LightWare-Optoelectronics/lightware-dji-sdk/README.md

# lightware-dji-sdk

Documentation and source code for integrating LightWare sensors into the DJI eco-system.

Please view the online documentation here: https://lightware-optoelectronics.github.io/lightware-dji-sdk/
