LightWare-Optoelectronics/lightware-dji-sdk/docs/landing-moving-platform/hardware/index.html

Skip to main content

On this page

# Hardware

## Sensor settings and firmware

Each LightWare LW20/C is pre-configured an I2C address of 0x66. To differentiate the four devices on the bus, each device will have to be configured with a unique address.

Configuration of the LightWare devices is accomplished with LightWare Studio (https://lightwarelidar.com/resources-software/).

Connect each sensor to the Generic USB adaptor. Update the firmware and change the I2C address as described in the Product Guide (https://lightwarelidar.com/resources-active-manuals-datasheets/).

LightWare Studio denotes the I2C addresses in decimal. The table below shows four decimal values for the corresponding hexadecimal values.

Decimal | Hex
102 | 0x66
103 | 0x67
104 | 0x68
105 | 0x69

Mark each sensor with its address as their position on the aircraft will be relevant for future logic setups.

## Assembling the hardware

### Sensor mounting

Start by preparing the mounting rails and clips that will hold the sensors securely on the underside of the aircraft.

Attach the mounting clips to the rails, which will later be secured to the drone. Using countersunk screws, fasten the clips as demonstrated in the image below to ensure a snug and stable fit for the sensors.

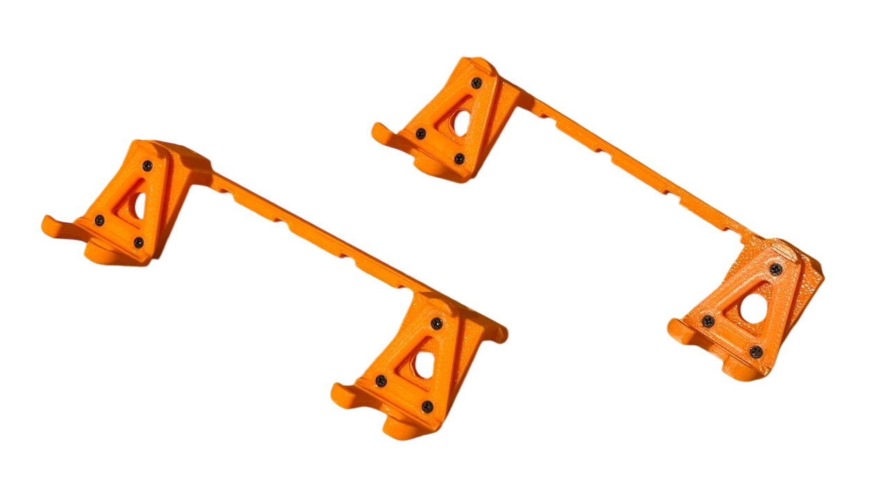
[picture p1: docs/assets/images/clipsonrails-0dd674a2cffb2f62185db07fd3b68879.png]
Mounted clips to the rails


### Communications cable preparation

Strip the pre-attached LightWare connector from the end of the communications cables from each of the LiDAR sensors and prepare the cable for connecting the Dupont connectors.

Connect the black (GND), red (VCC), white (RX/SCL), and yellow (TX/SDA) wires from the LW20/C and crimp each one individually using Dupont connectors. Ensure each wire is firmly secured within its connector to avoid any loose connections.

Once crimped, insert the wires into a single 4-pin Dupont housing in the following order:

- Black (GND)
- Red (VCC)
- White (RX/SCL)
- Yellow (TX/SDA)

This will ensure proper alignment for easy connection to the appropriate ports on the onboard computer or other components.

Double-check that the wires are inserted in the correct order and securely held within the connector housing.

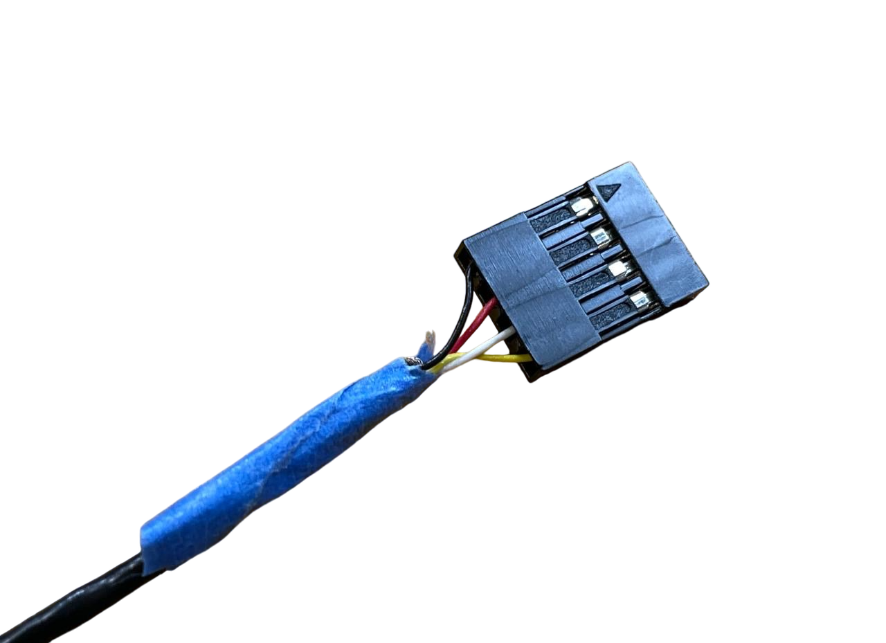
[picture p2: docs/assets/images/crimpedwiresonlw20-8d907b380153e8a405eb422df559ffc8.png]
Crimped Wires on LW20/c


### Mounting the sensors

Begin by attaching the 3D-printed bracket to the underside of the M350 drone. Carefully flip the aircraft upside down - it's best to do this step now since the computer will be installed later.

Remove the payload screws and set them aside in case it is needed to detach the kit in the future.

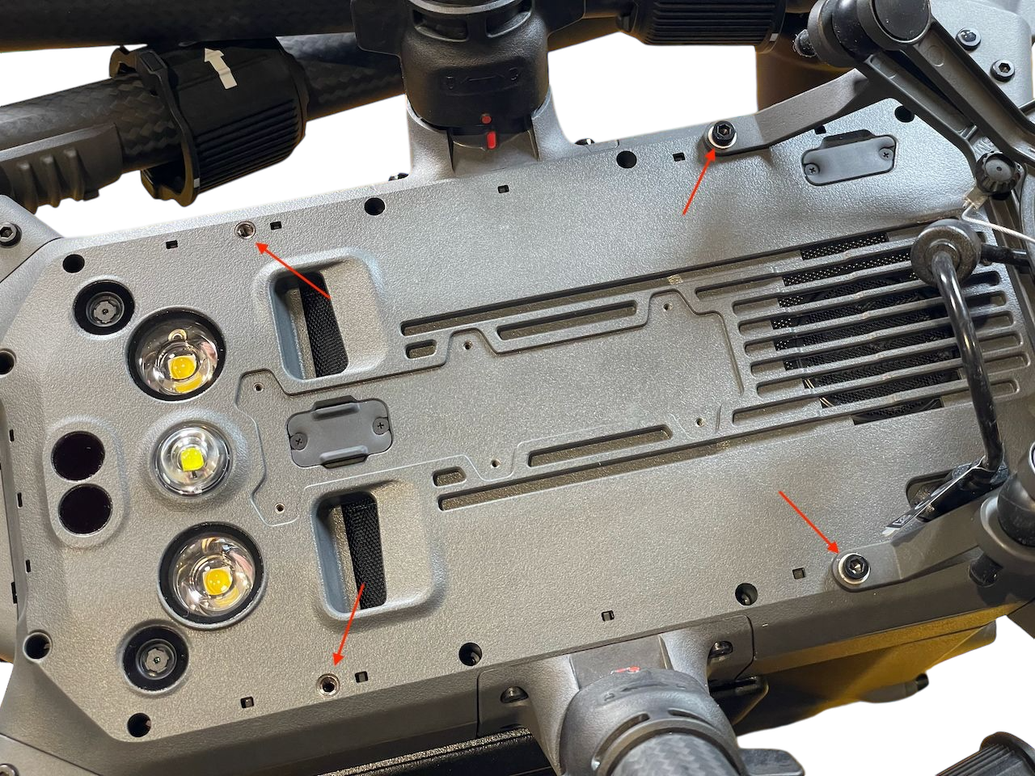
[picture p3: docs/assets/images/m350onitshead-d6d881d67124785eacda940005cbc7aa.png]
M350 on its head


Secure the rails to the drone using M3x10mm screws for the front (where the payload is located) and M3x8mm screws for the back.

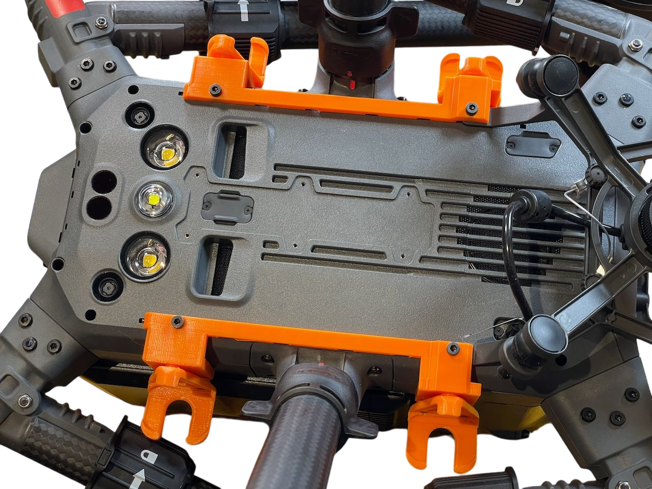
[picture p4: docs/assets/images/railsinstalled-2eea33e8801ef78d0a54aa22e9cdf384.png]
Rails installed


Next, clip the sensor onto the 3D-printed bracket. To manage the cables, use adhesive putty (like Blu Tack or similar) to keep them neatly secured against the body of the aircraft.

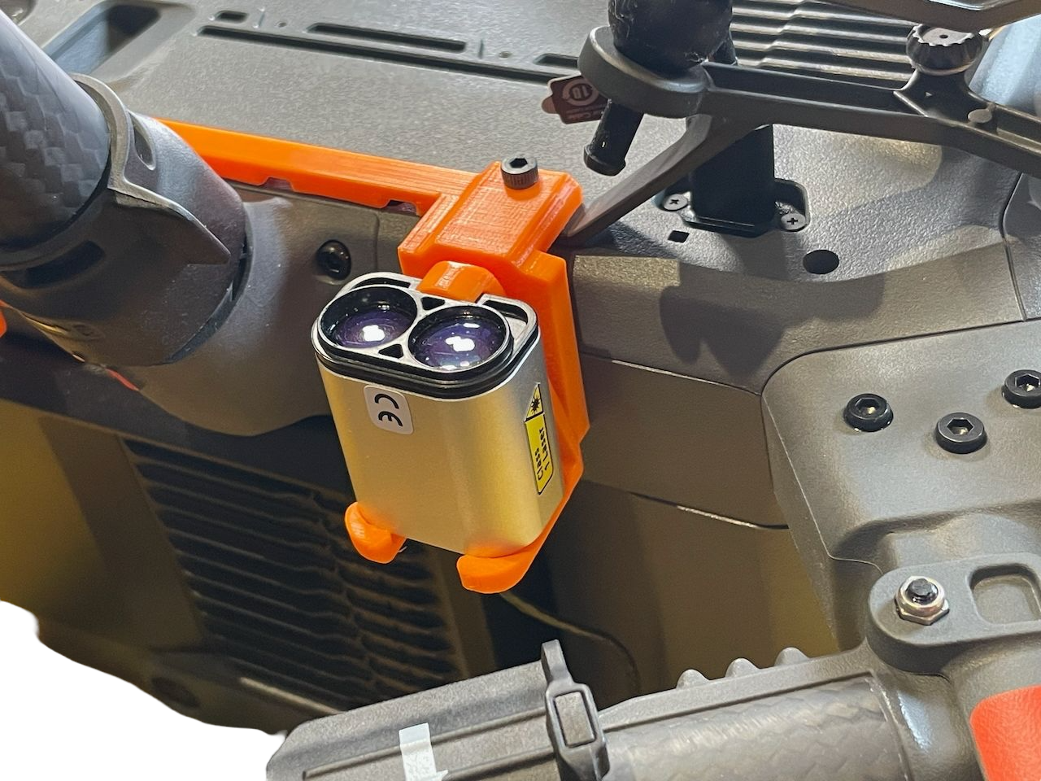
[picture p5: docs/assets/images/lw20installed-0057602dd733ce7a632730611499ee80.png]
LW20/c installed and wire attached with blutac
 LW20/c installed and wire attached with blutac

Alternative cable routing

For production deployments, there are more durable methods to secure the cables, including printing a cable guide brace between the two mounting brackets. This guide focuses on R&D and quick validation of the end-to-end system. An alternative option would be to route the cables through the rails and secure them with zip ties. The rails are designed to accommodate this. The wire length may need to be extended for the rear sensors. The cables can also be guided along the side of the aircraft using adhesive putty, taking care not to obstruct the view of the obstacle avoidance sensors.

### Preparing the compute unit mounting

Use M2.5 heat-set inserts for the Raspberry Pi posts on the compute mount. Use a soldering iron at the melting temperature appropriate for the plastic used in the printing of the mount. Carefully insert the heat-set and remove the iron once the insert is sufficiently embedded.

The heat-set inserts are optional but recommended for a more secure fit. An alternative would be to use self-tapping screws directly into the plastic mount.

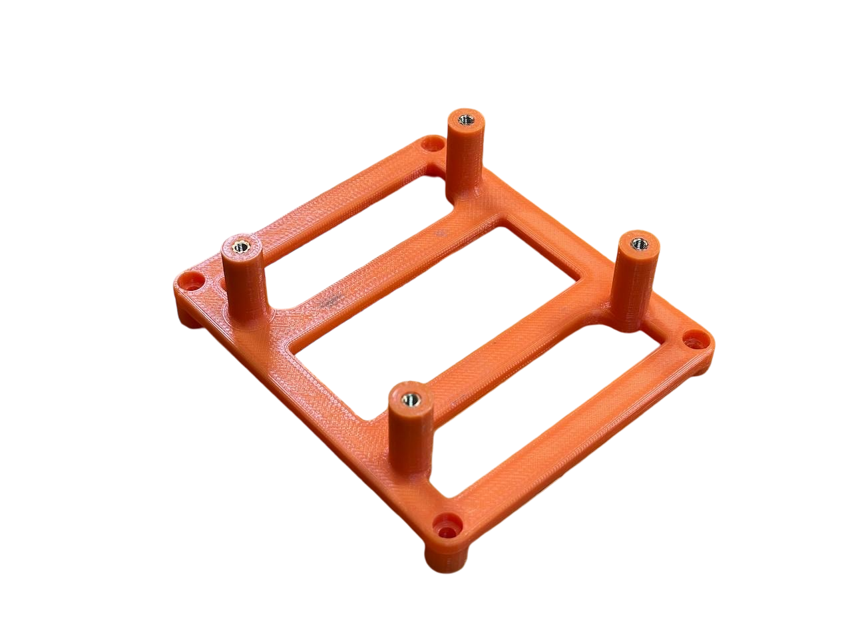
[picture p6: docs/assets/images/computemountwiththreaded-6a1992a9199ea5ea620ba9f0d8d41797.png]
Compute mount with threaded insert posts


### Preparing the voltage regulator mounting

The voltage regulator which will supply power to the Raspberry Pi and the I2C breakout board.

Install the heat-set inserts into the board, following the same process used previously. Use a soldering iron at the appropriate temperature to ensure the inserts are securely in place.

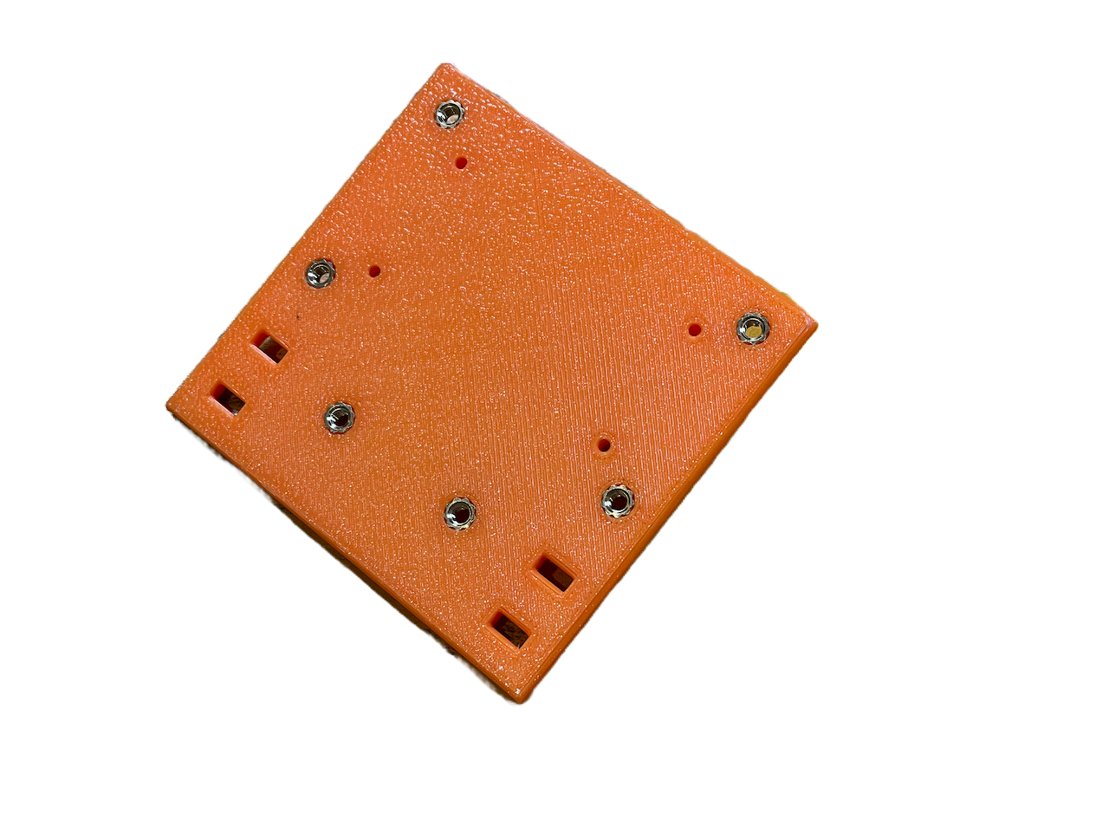
[picture p7: docs/assets/images/voltageboardwithinserts-5d5ddf76be71025a42b82e306a12f6ed.png]
Voltage board with inserts


When using an alternative I2C bus and voltage regulator configuration, ensure that the required power is supplied for the Raspberry Pi to function properly.

### Mounting the E-Port kit

The E-Port Kit will be positioned underneath the Raspberry Pi. Place the E-Port kit as seen on the picture below, aligning the E-Port kit inside the securing post.

Secure the board to the mount using a zip tie.

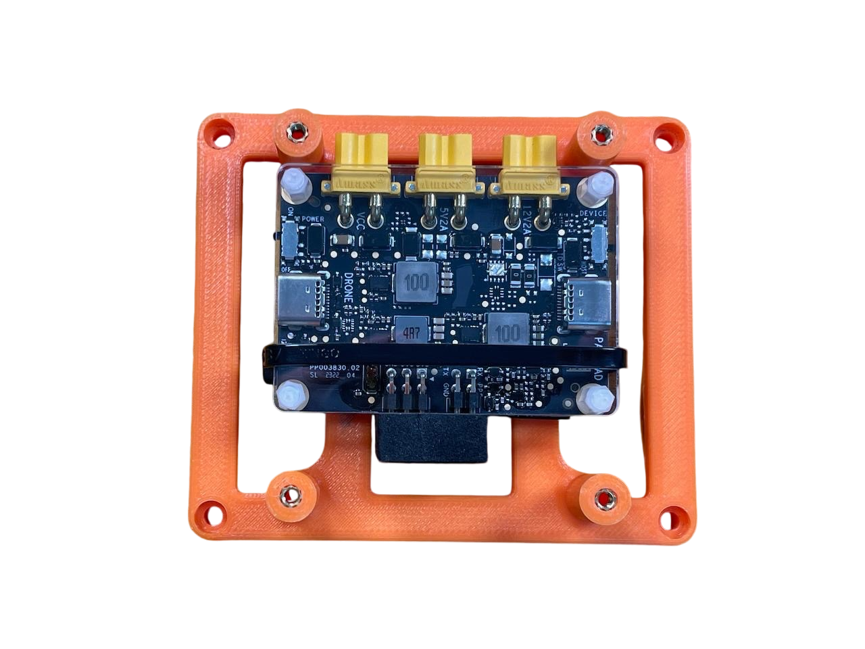
[picture p8: docs/assets/images/eportonmount-82ff57d64357cf5bc505caa2b5e3919b.png]
E-port on mount


Ensure that the "Drone" USB-C port on the E-Port Kit is facing the starboard (right) side of the mount. This orientation is crucial for proper functionality.

Verify that the E-Port Kit is firmly in place before proceeding to the next step.

### Connect the USB/TTL cable

While having a clear view of the markings on the PCB, and before moving on to the Raspberry Pi, connect the USB/TTL cable to the pins on the E-Port Kit.

Connect the USB-C cable from the kit, ensuring that the "B" side of the cable is facing upwards.

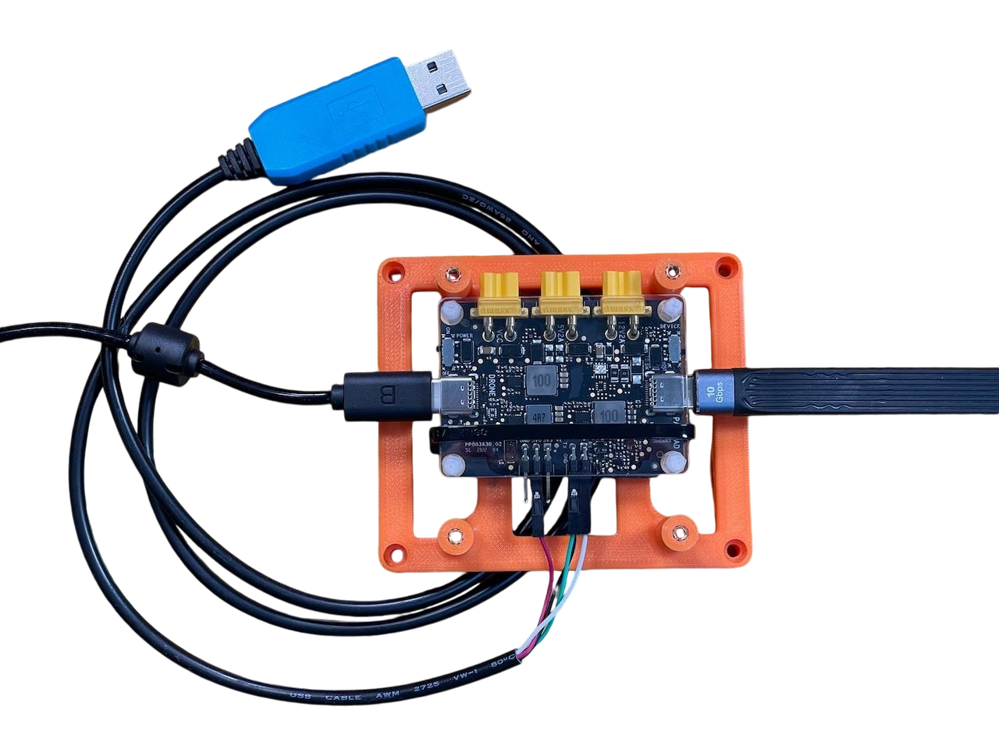
[picture p9: docs/assets/images/eportkitinstalled-f5f87e6e60f371ee0b5a5ddad58449bb.png]
E-Port Kit installed


The USB-C cable used for DJI development is not reversible. Pay close attention to the "A" and "B" side orientations as specified in the DJI developer documentation (https://developer.dji.com/doc/payload-sdk-tutorial/en/quick-start/device-connect.html).

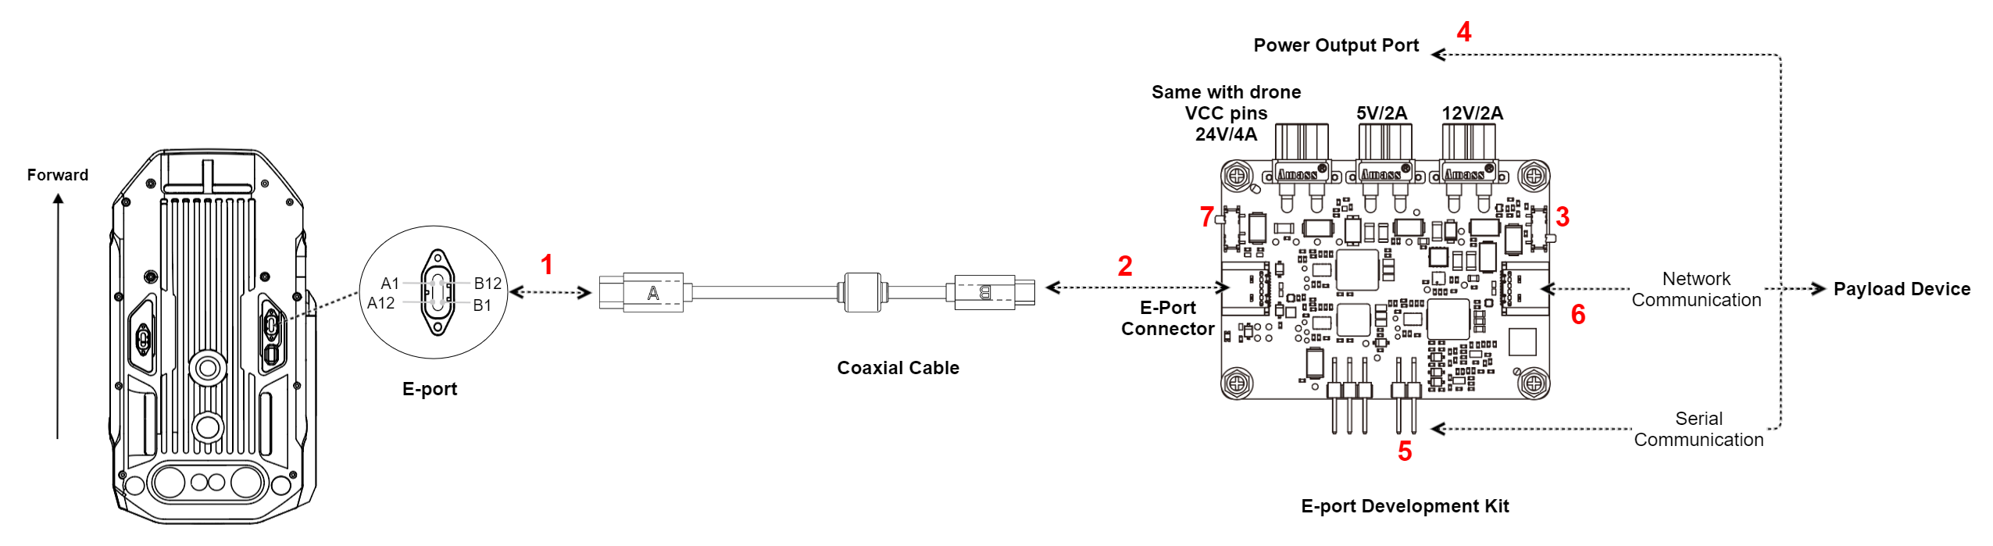
[picture p10: docs/assets/images/m350-eport-connect-en-d437e88dfb292e3033da55b9ba1755d4.png]
M350 E-Port Dev Kit Connection


Do not connect the cable to the aircraft.

### Mounting the Raspberry Pi

The mount provide is designed for through-hole installation compatible with the bare board or the official Raspberry Pi case.

Use M2.5x6mm screws to attach the Raspberry Pi to the mount, ensuring that the connectors are facing the back of the aircraft.

Be careful not to overtighten the screws to avoid damaging the board.

### Confirm the assembly

Based on the preceding steps, the design should have the following configuration.

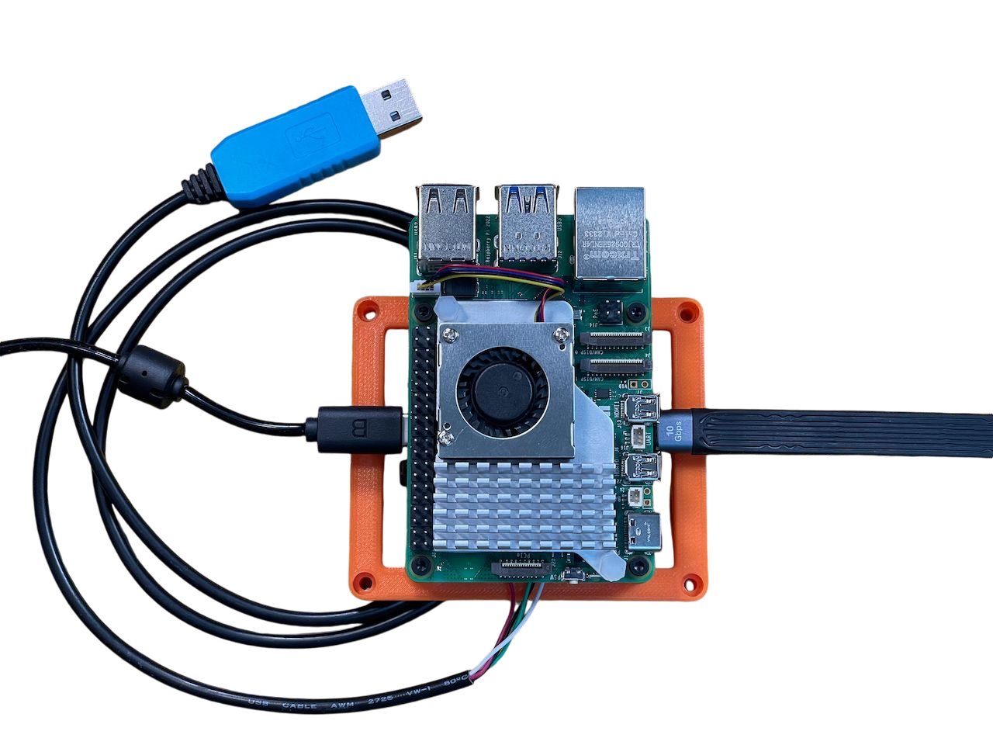
[picture p11: docs/assets/images/raspberrypiinstalled-b1f8021f3e47da238dfb04a5adba82ea.png]
Raspberry Pi Install


### Secure the voltage regulator and I2C breakout

Use M3x6mm screws to securely attach both the voltage regulator and the I2C bus breakout to the side board.

Ensure that both components are firmly secured to prevent any movement during operation.

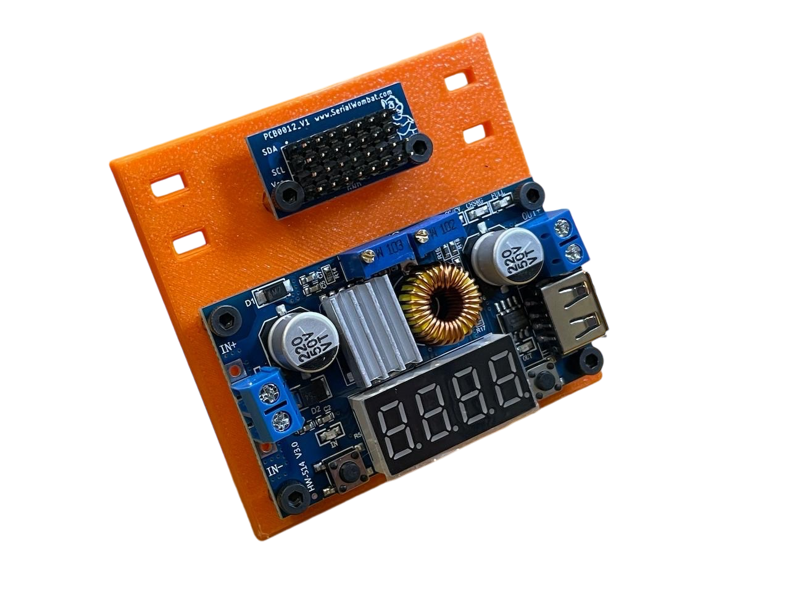
[picture p12: docs/assets/images/assembledsideboardnotwired-71e604b253e671aa64f08d3c9f26074b.png]
Assembled side board


Attach the E-Port power cable to the input terminals of the voltage regulator and the Raspberry Pi power cable to the output terminals of the voltage regulator.

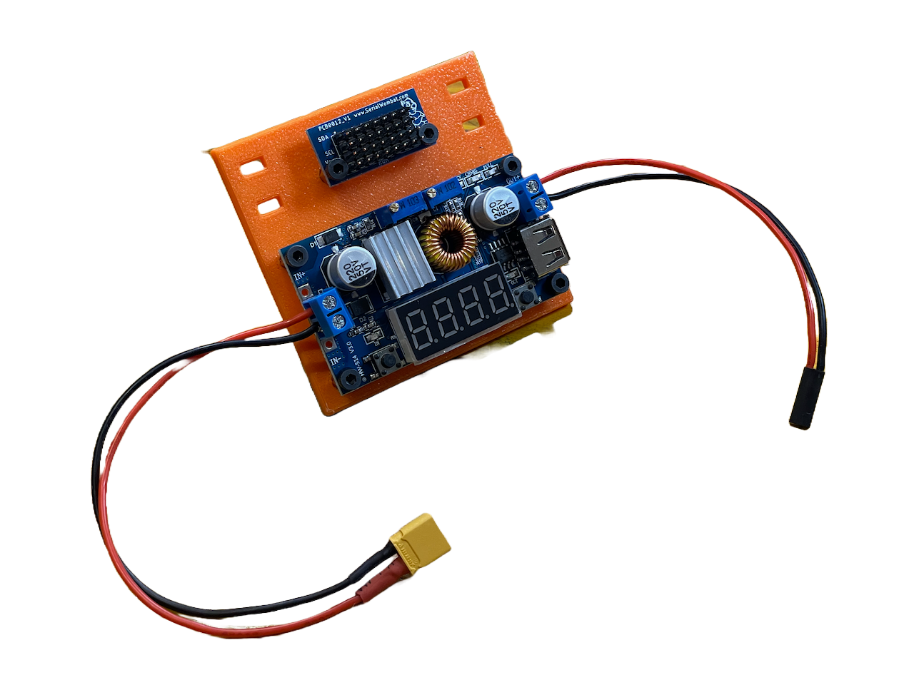
[picture p13: docs/assets/images/assembledsideboard-75023d5b256e293621b7ab417456e375.png]
Assembled side board


Ensure that no power is supplied to the voltage regulator at this point. The correct voltage will be configured in a later step.

### Adding the Raspberry Pi

Follow the provided instructions to set up the SD card for the Raspberry Pi: Follow these instructions to get it done (https://www.raspberrypi.com/documentation/computers/getting-started.html)

Once complete, insert the SD card into the slot on the Raspberry Pi. Clip the side board to the front of the Raspberry Pi's mount.

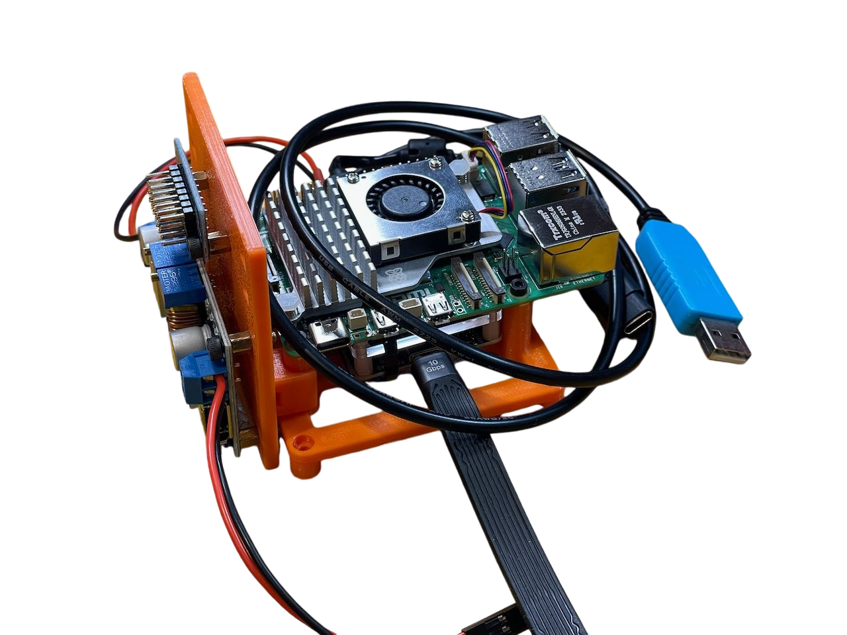
[picture p14: docs/assets/images/sideboardattachednotwired-9b6816cb77fb5022d745456405a8481b.png]
Side board attached, not wired


Note

The round clip would be enough to secure it, but if you want, you can secure them further with zip ties.

Attach the XT30 power cable to the unregulated power connector on the E-Port Dev Kit.

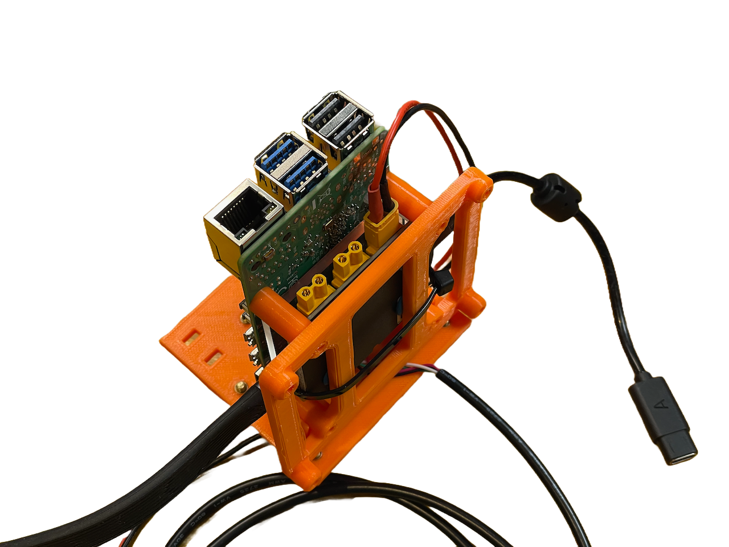
[picture p15: docs/assets/images/xt30connected-262263767a1c89143a150eca8ecf149f.png]
XT30 connected


Plug the short USB-C cable into the device USB port on the E-Port Dev Kit and the other end into the Raspberry Pi's USB port - this will act as the fast data line.

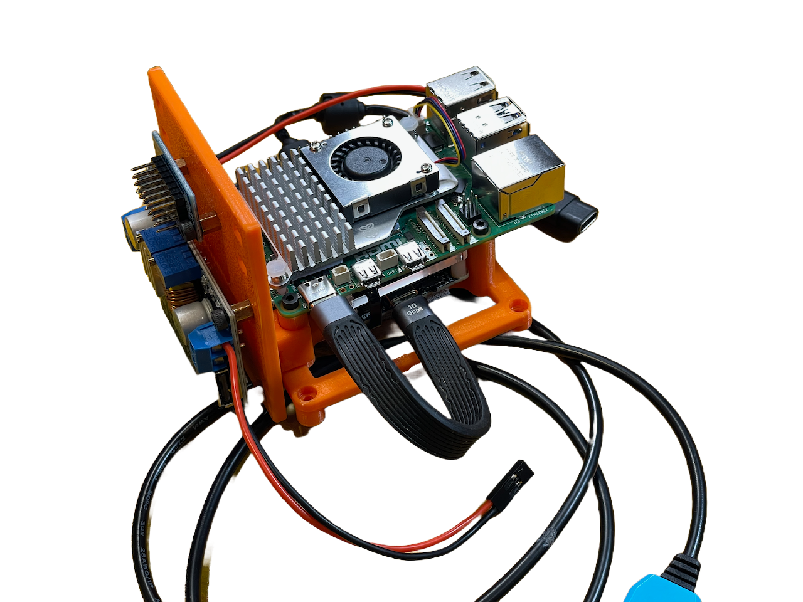
[picture p16: docs/assets/images/usbcconnected-bc82ce00432e48f0cb38ea7be9e3a272.png]
USB-C connected


Coil the USB to TTL cable around the base of the mount and connect the USB-A end to one of the Raspberry Pi's USB ports. Secure the cable against the frame with zip ties, if desired.

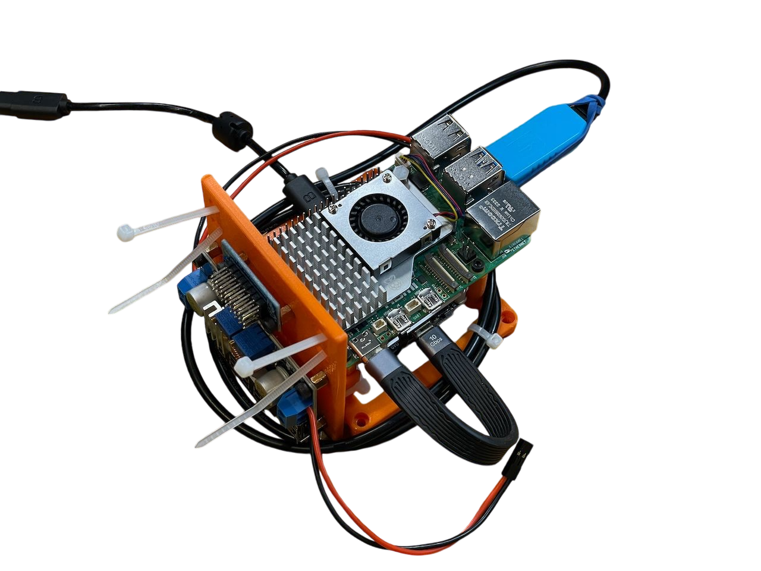
[picture p17: docs/assets/images/ftdicconnected-bff20cb8590ba6d8e9d9b4622be654fb.png]
ftdi connected


The schematic layout of the design up to this point is shown below:

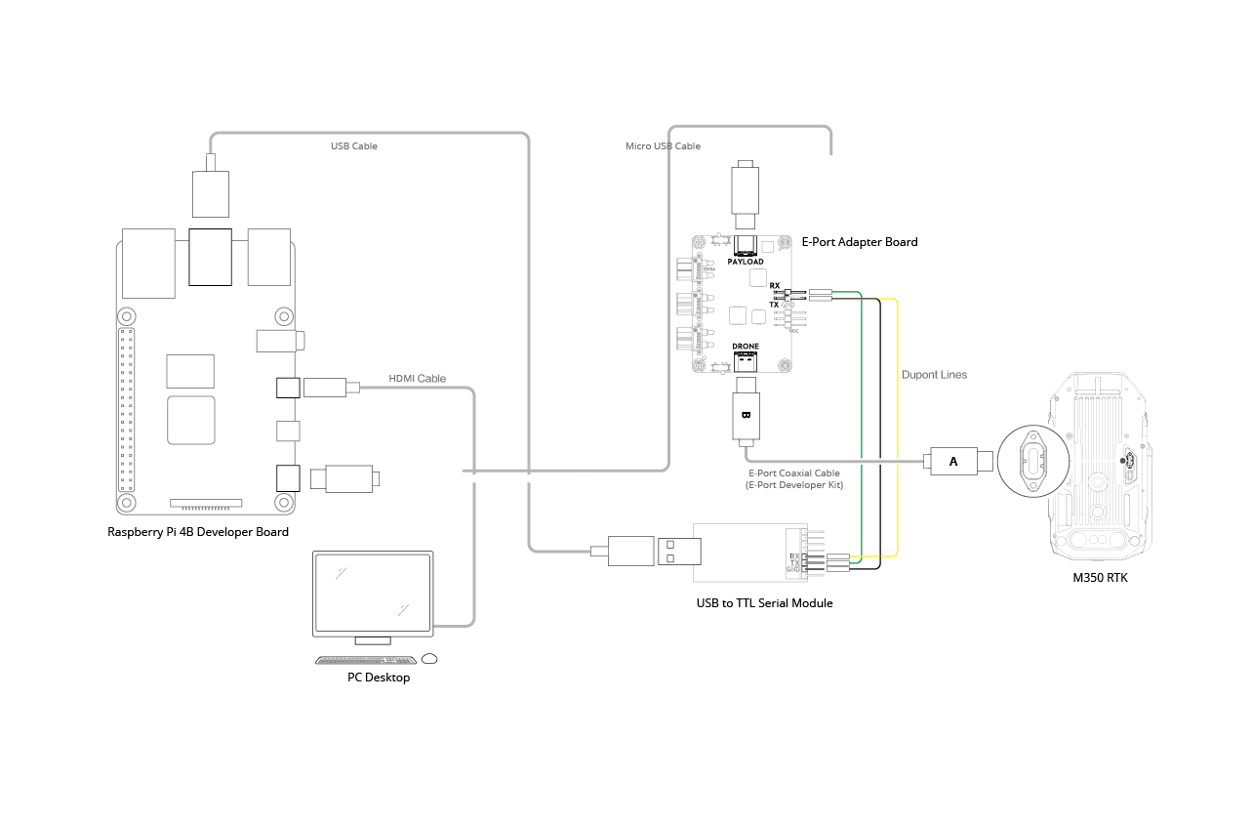
[picture p18: docs/assets/images/rasp-eport-connect_en-1cb83ee2a1d6a82a68230d9ab65d2a83.png]


Wiring diagram from DJI's Developer Documentation (https://developer.dji.com/doc/payload-sdk-tutorial/en/quick-start/quick-guide/raspberry-pi.html).

## I2C connection

Using Dupont cables, connect each of the I2C lines to the appropriate pins on the Raspberry Pi (GPIO2 = Pin 3 and GPIO3 = Pin 5). Reserve pins 4 and 6 on the Raspberry Pi for the power input from the voltage regulator.

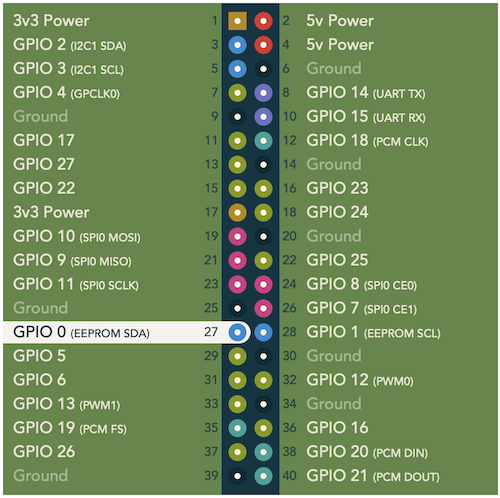
[picture p19: docs/assets/images/pi_pinout-a69a79762c3aab43f0ba9c6b87f5df21.png]
Raspberry Pi Pinout
 Pinout from pinout.xyz (https://pinout.xyz/pinout/pin27_gpio0/)

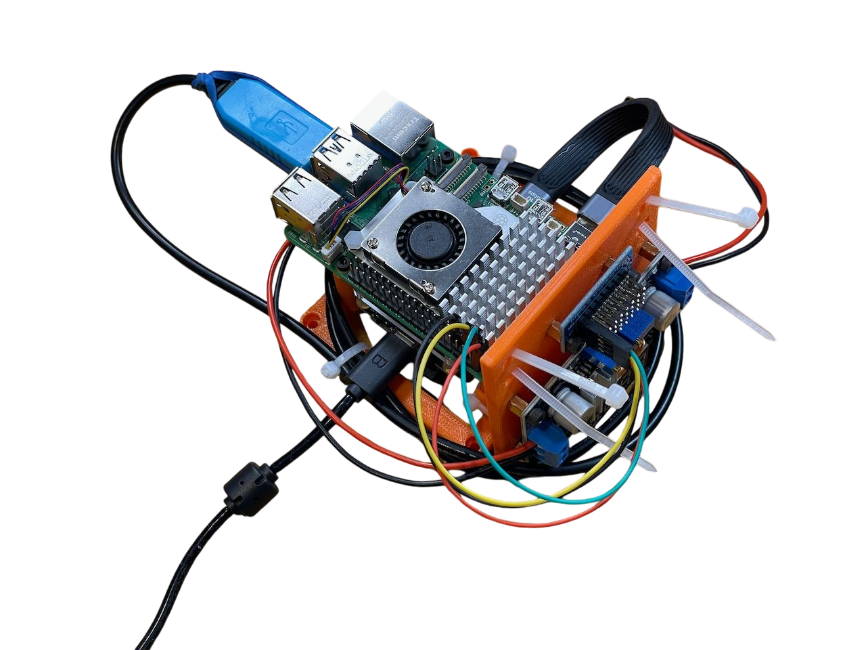
[picture p20: docs/assets/images/i2conpi-bf3ae0a331ac2446544ef5eb782b7601.png]
I2C on Pi


Finally, connect the sensor lines from each individual LightWare LiDAR to the I2C bus. At this point, the only unconnected cable should be the power cable output of the voltage regulator.

Note

The power cable output from the voltage regulator should remain disconnected until the regulator is configured with the aircraft's power supply.

## Aircraft installation

Secure the assembled kit to the aircraft using M3x8mm screws at the back and M3x15mm screws at the front.

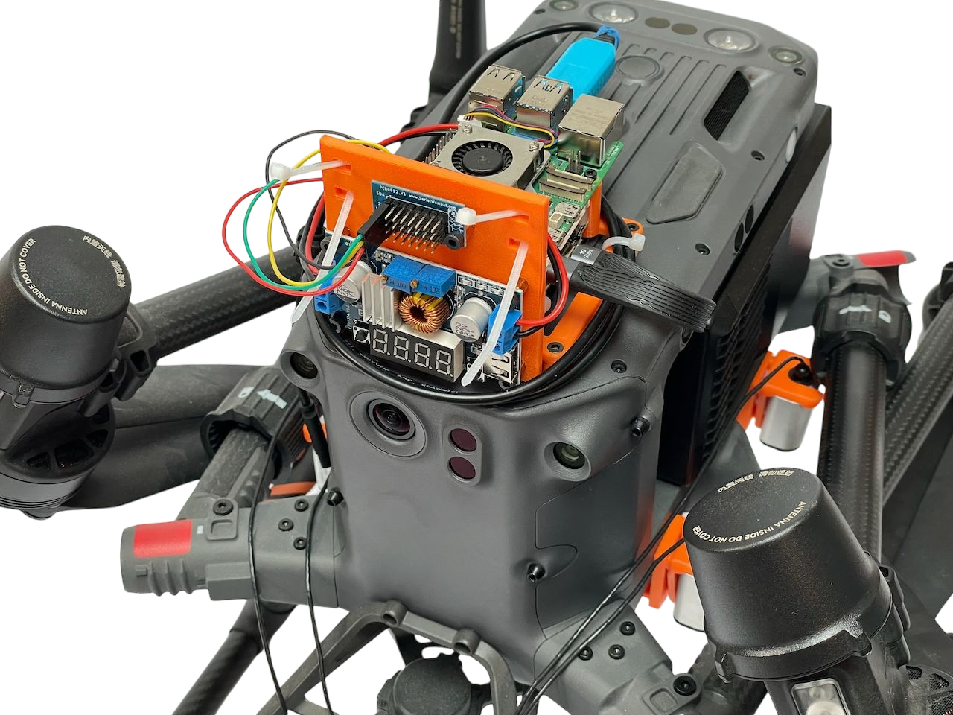
[picture p21: docs/assets/images/kitonm350-2038fd2d6bc7ce441afd72f8658ecb04.png]
Kit on M350


Once the development kit is securely mounted, connect the USB-C cable to the aircraft.

Note

As previously mentioned, the USB-C cable used for DJI development is not a standard reversible cable. It has designated "A" and "B" sides, so be sure to follow the orientation guidelines in the DJI developer documentation (https://developer.dji.com/doc/payload-sdk-tutorial/en/quick-start/device-connect.html): M350 E-Port Dev Kit Connection

At this point, the kit will power on when the aircraft is activated, enabling data communication with the vehicle. However, please note that while the kit can connect to the aircraft, the Raspberry Pi might not receive its full power requirements until the voltage regulator is properly configured.

## Voltage configuration

Ensure that the switches on the E-Port Dev Kit are set correctly by confirming that the switch at the drone's USB-C side is set to "on", and that the payload USB-C side switch is set to host mode.

On the voltage regulator, adjust the voltage by turning the potentiometer for the voltage limit. If unsure, refer to the markings on the PCB.

Power on the aircraft to confirm that the voltage regulator is operational. The model we've selected includes a digital display and indicator LEDs for monitoring.

Warning

The display on this voltage regulator is only for information; cycling through modes won't affect the output voltage.

While the aircraft is powered on, use a multimeter to measure the output voltage from the regulator's output terminal. Adjust thevoltage-limiting potentiometer until 5V is reached.

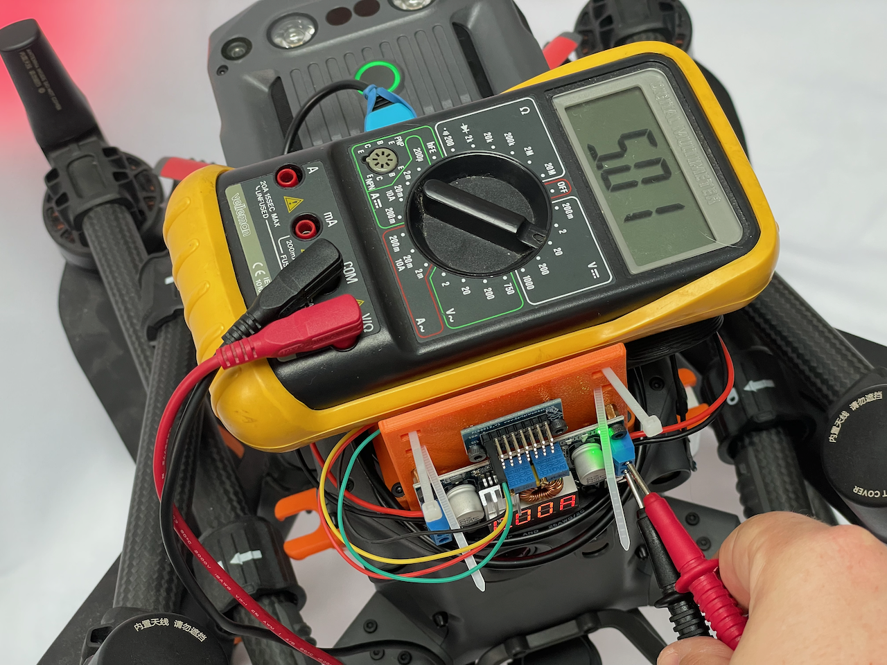
[picture p22: docs/assets/images/voltageregpoweredon-637e6d857d77d64321b31769b9db71bf.png]
Voltage Regulator Powered


## Power connections

Power off the aircraft before proceeding.

Connect the output power lead from the voltage regulator to the power pins on the Raspberry Pi. Refer to the pinout diagram above or the image below.

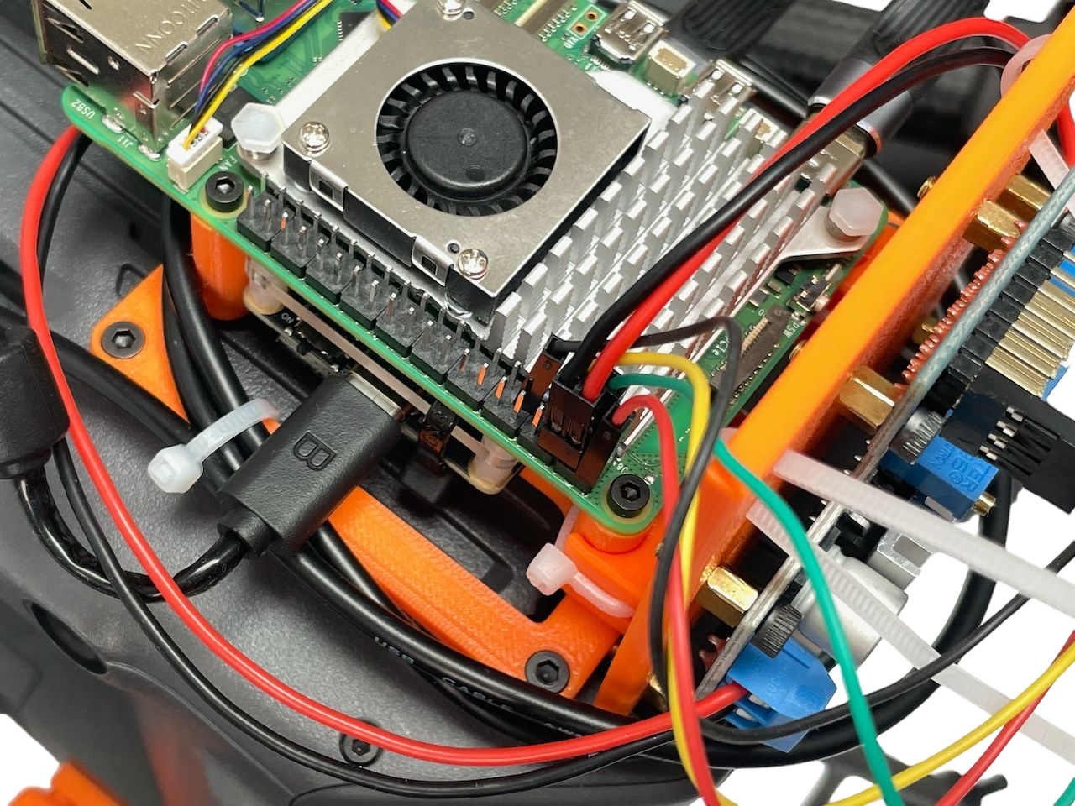
[picture p23: docs/assets/images/raspberrypipowerpins-49fec268e4f17b9730472929ff59f8b7.png]
Raspberry Pi Power Pins


Connect the sensor lines to the I2C bus.

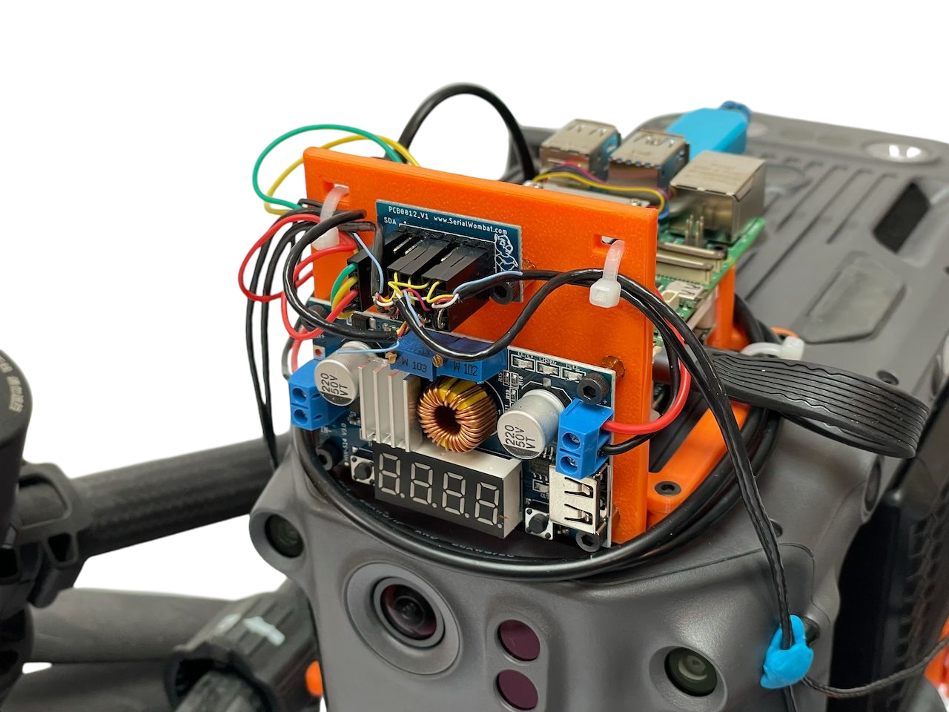
[picture p24: docs/assets/images/sensoronbus-747f2dbe7816c37ac89419ea0b3d019b.png]
Sensor on bus


To tidy up, secure all loose cables with zip ties, making sure the setup remains easily removable for future maintenance and development.

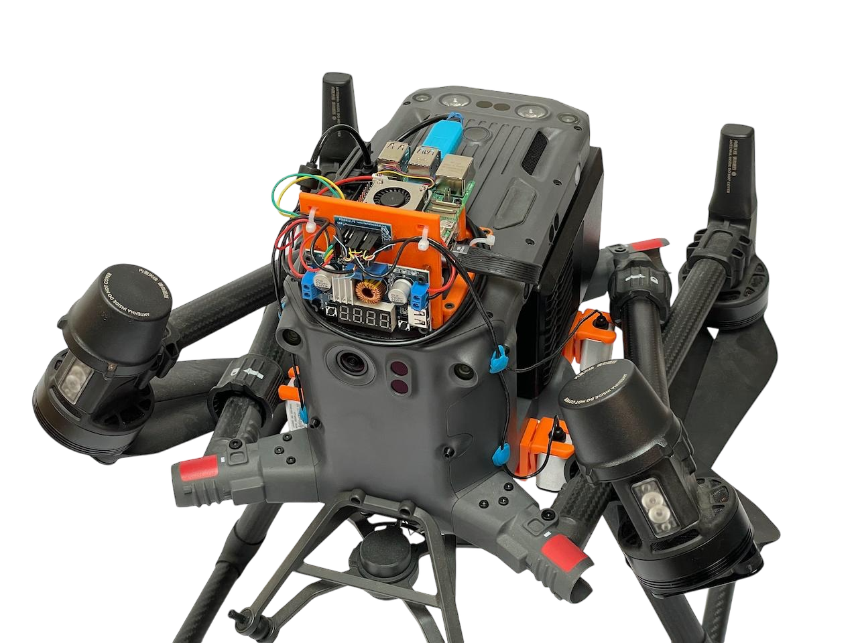
[picture p25: docs/assets/images/finalhardwarestate-b96941e5d34c49c04bd95e55f72d91b0.png]
Final Hardware State


- Sensor settings and firmware
- Assembling the hardware
  - Sensor mounting
  - Communications cable preparation
  - Mounting the sensors
  - Preparing the compute unit mounting
  - Preparing the voltage regulator mounting
  - Mounting the E-Port kit
  - Connect the USB/TTL cable
  - Mounting the Raspberry Pi
  - Confirm the assembly
  - Secure the voltage regulator and I2C breakout
  - Adding the Raspberry Pi
- I2C connection
- Aircraft installation
- Voltage configuration
- Power connections

Copyright © 2025 LightWare Optoelectronics (Pty) Ltd. All rights reserved.
