LightWare-Optoelectronics/lightware-dji-sdk/docs/assets/images/51T-u-EJAxL._AC_SL1001_-9107ac276c88fd1c78ee357189197181.jpg

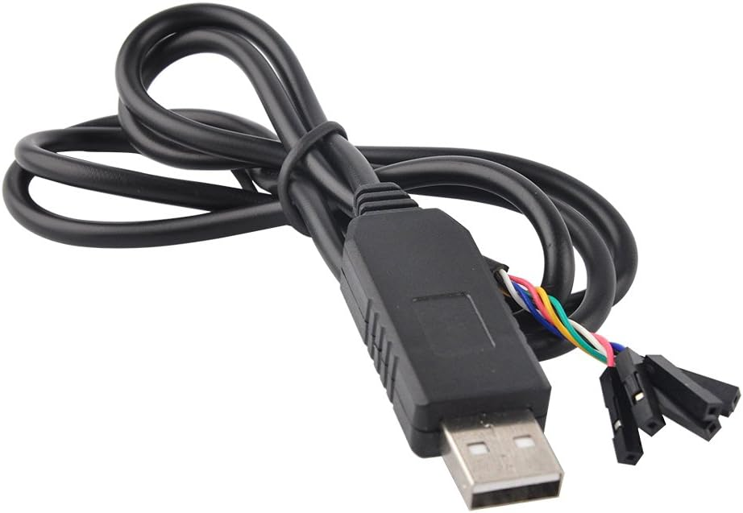
docs/assets/images/51T-u-EJAxL._AC_SL1001_-9107ac276c88fd1c78ee357189197181.jpg
