LightWare-Optoelectronics/lightware-dji-sdk/docs/assets/images/61KCEyc7R3L._AC_SL1500_-c177cbe61d595c2ea7ebc119938e084b.jpg

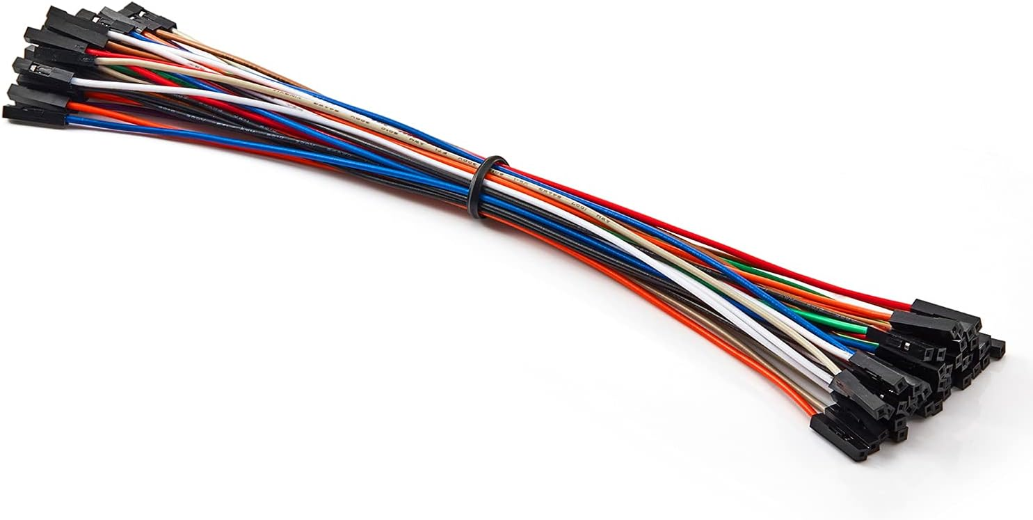
docs/assets/images/61KCEyc7R3L._AC_SL1500_-c177cbe61d595c2ea7ebc119938e084b.jpg
