LightWare-Optoelectronics/lightware-dji-sdk/docs/assets/images/61ywQxu4AiL._AC_SL1001_-1cacf7bdea5adb2c449da424fed287e7.jpg

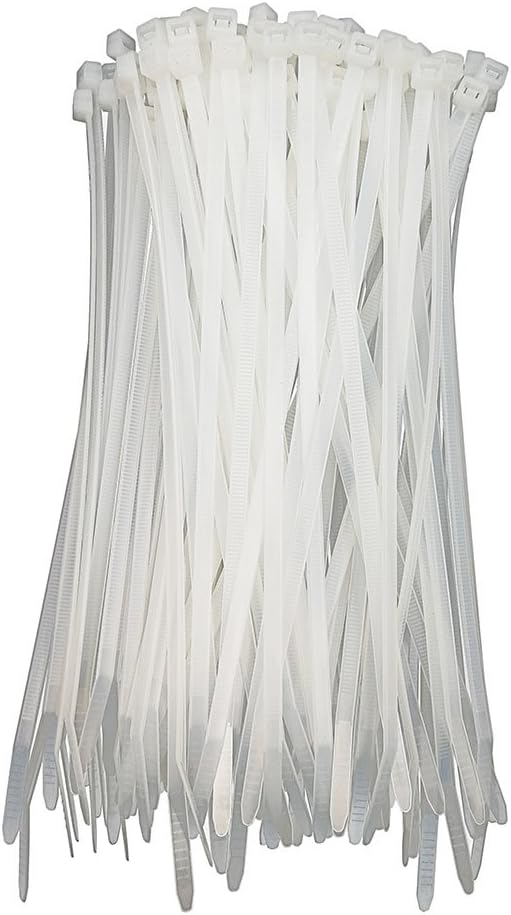
docs/assets/images/61ywQxu4AiL._AC_SL1001_-1cacf7bdea5adb2c449da424fed287e7.jpg
