LightWare-Optoelectronics/lightware-dji-sdk/docs/assets/images/61Zsa-XdFoL._AC_SL1000_-222941ddfec63e9cecb9fbda90e0cf47.jpg

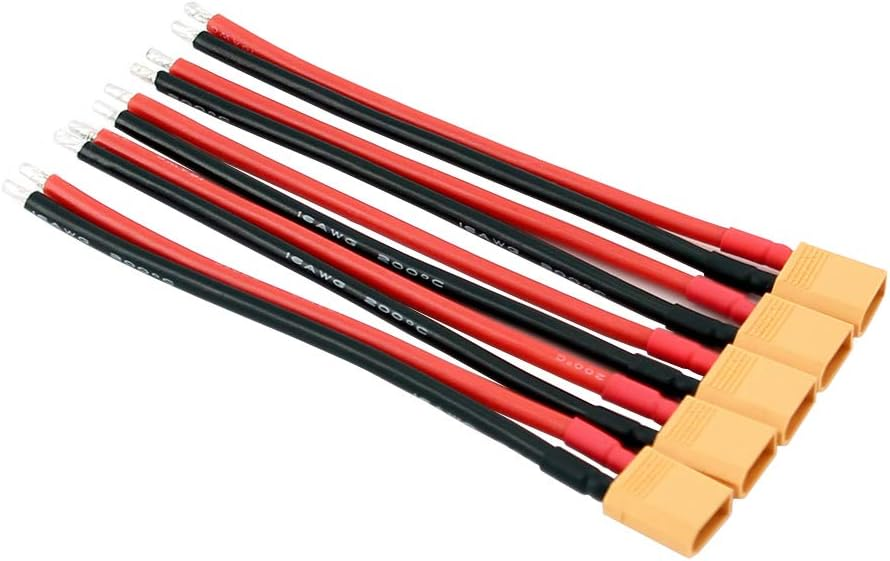
docs/assets/images/61Zsa-XdFoL._AC_SL1000_-222941ddfec63e9cecb9fbda90e0cf47.jpg
