LightWare-Optoelectronics/lightware-dji-sdk/docs/assets/images/71EDBA-cjSL._AC_SL1500_-2e9e45a7f3ade3a2ed337bf567c3f312.jpg

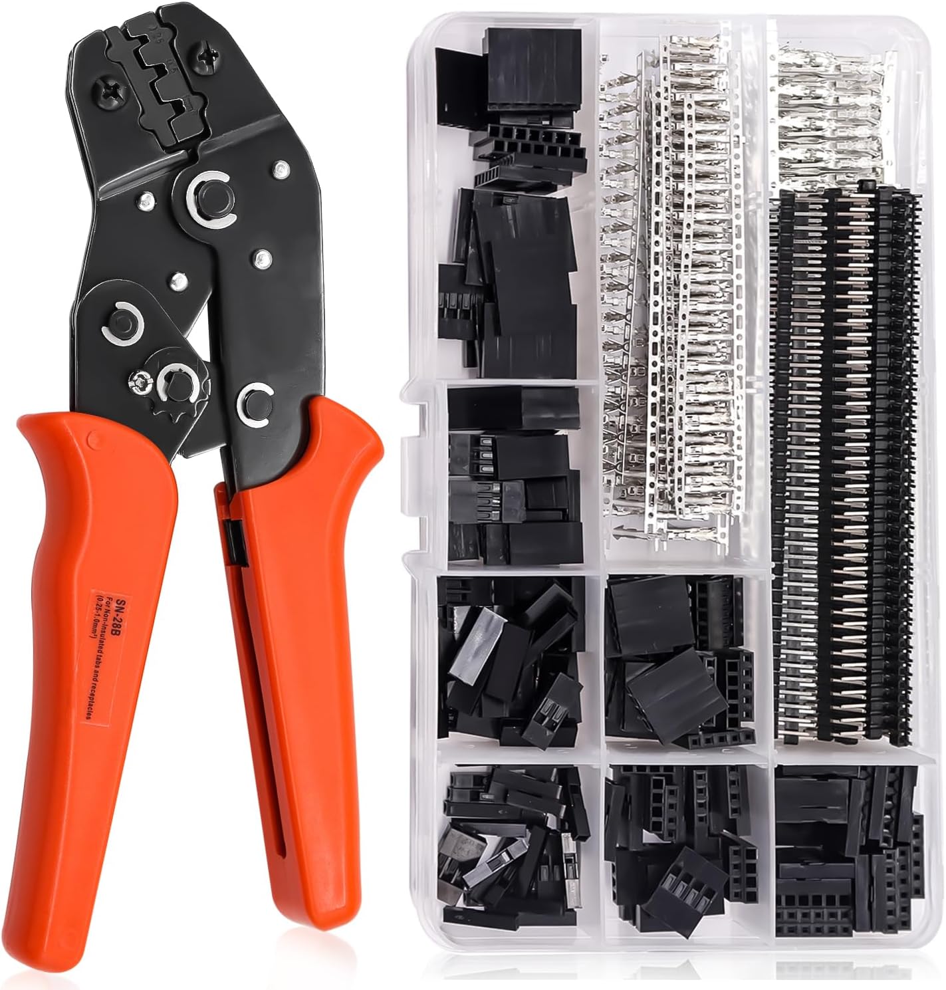
docs/assets/images/71EDBA-cjSL._AC_SL1500_-2e9e45a7f3ade3a2ed337bf567c3f312.jpg
