LightWare-Optoelectronics/lightware-dji-sdk/docs/assets/images/71juoWi2FiL._AC_SL1500_-11a714812908405fd3d4f42da9cdcfc5.png

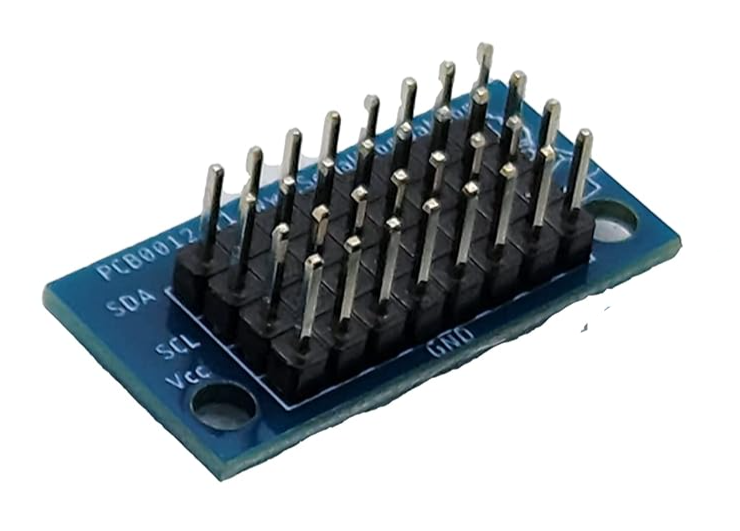
docs/assets/images/71juoWi2FiL._AC_SL1500_-11a714812908405fd3d4f42da9cdcfc5.png
