LightWare-Optoelectronics/lightware-dji-sdk/docs/assets/images/71OT7iBAbNL._SL1500_-eb91bae33b8e137c100dc9f8c941f24a.jpg

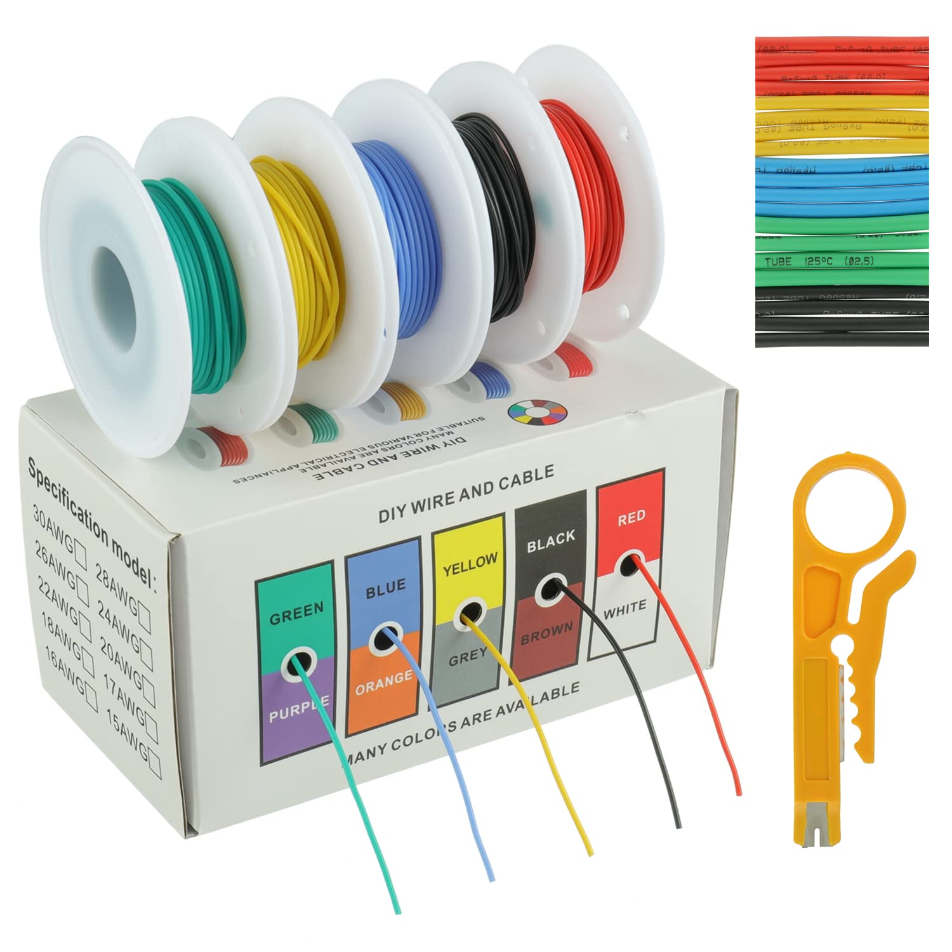
docs/assets/images/71OT7iBAbNL._SL1500_-eb91bae33b8e137c100dc9f8c941f24a.jpg
