LightWare-Optoelectronics/lightware-dji-sdk/docs/assets/images/71qw+++GSiL._SL1500_-f964f65cab8eb880572ce08fd3b3c153.jpg

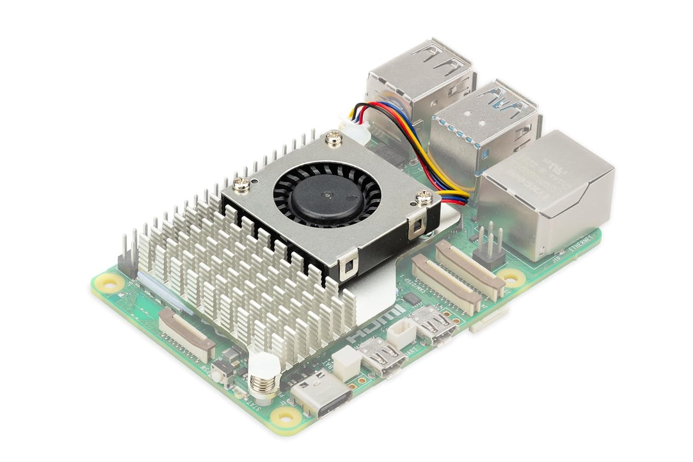
docs/assets/images/71qw+++GSiL._SL1500_-f964f65cab8eb880572ce08fd3b3c153.jpg
