LightWare-Optoelectronics/lightware-dji-sdk/docs/assets/images/71rvtEumD4L._AC_SL1500_-ea0050e845c4db6105a6d4537b43f433.jpg

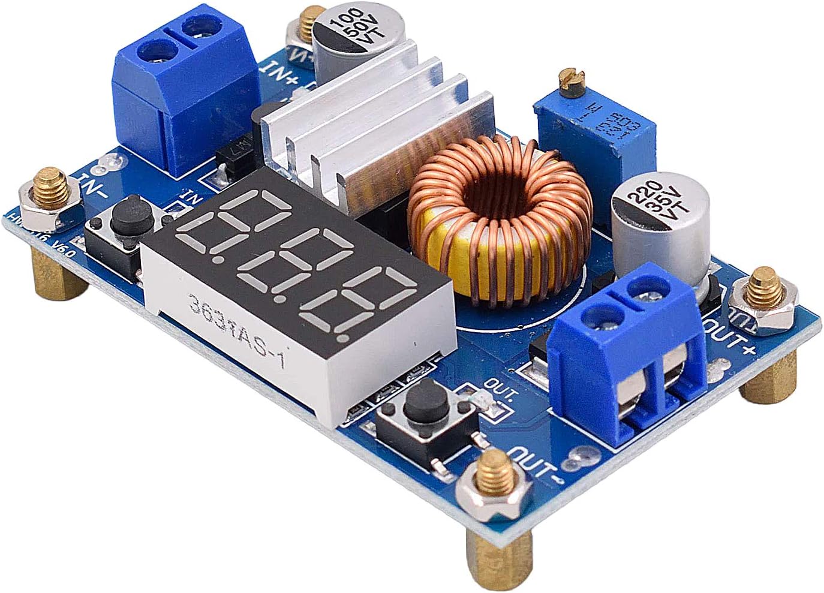
docs/assets/images/71rvtEumD4L._AC_SL1500_-ea0050e845c4db6105a6d4537b43f433.jpg
