LightWare-Optoelectronics/lightware-dji-sdk/docs/assets/images/81APbUgSiML._AC_SL1500_-d5b4520d5cf75acbd66ce84c54c599f9.jpg

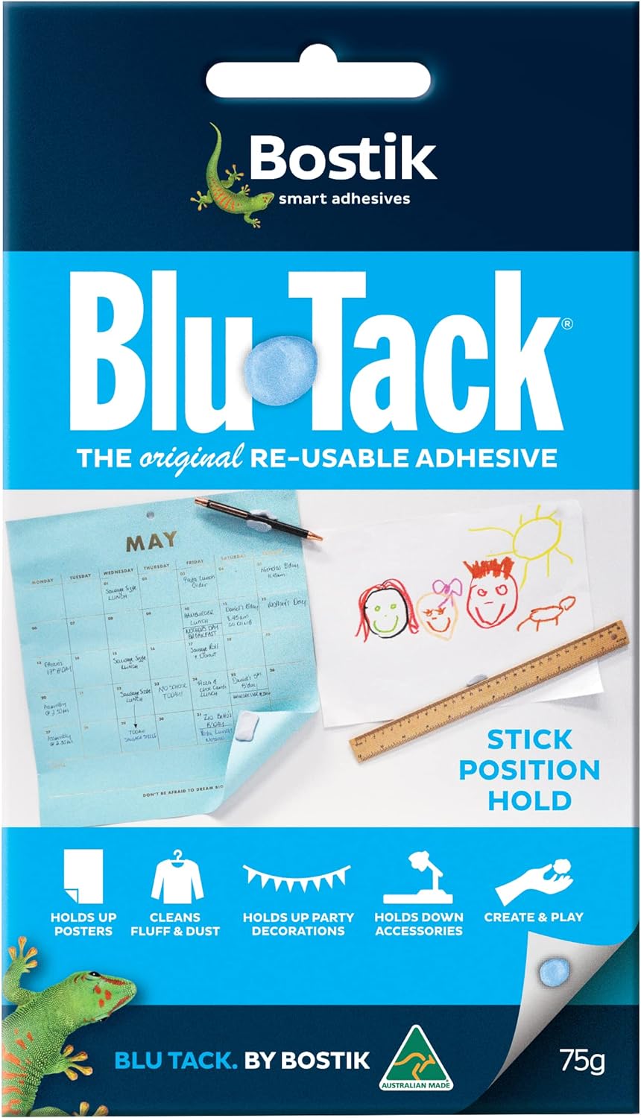
docs/assets/images/81APbUgSiML._AC_SL1500_-d5b4520d5cf75acbd66ce84c54c599f9.jpg
