LightWare-Optoelectronics/lightware-dji-sdk/docs/assets/images/81XB4LUuFOL._AC_SL1500_-a6dbcea6f2f424bf66bc60cb1e9e5a61.jpg

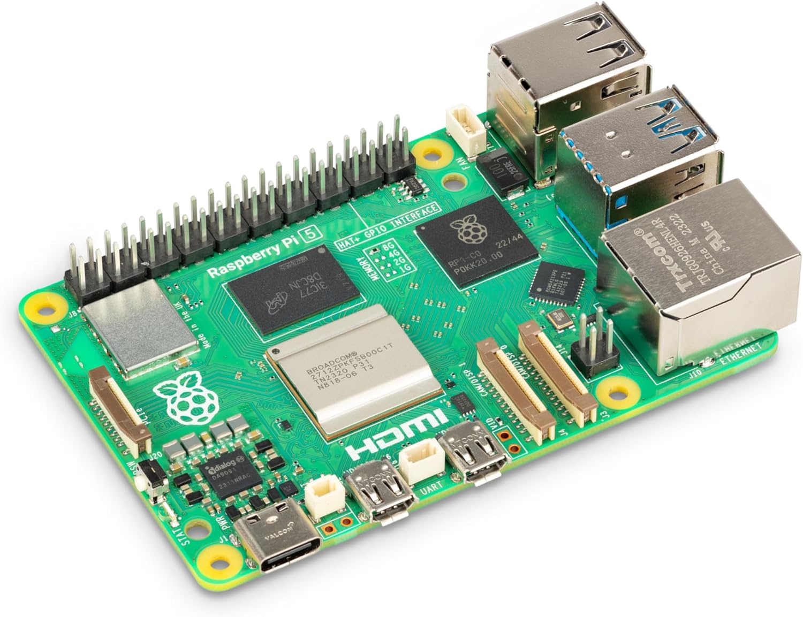
docs/assets/images/81XB4LUuFOL._AC_SL1500_-a6dbcea6f2f424bf66bc60cb1e9e5a61.jpg
