LightWare-Optoelectronics/lightware-dji-sdk/docs/assets/images/91290A101_2d622f8b-3c28-4a8b-9832-15b6ba9e981d@4x_638090344480111980-20c283fe82cabf8ed7d289f3393e69f2.png

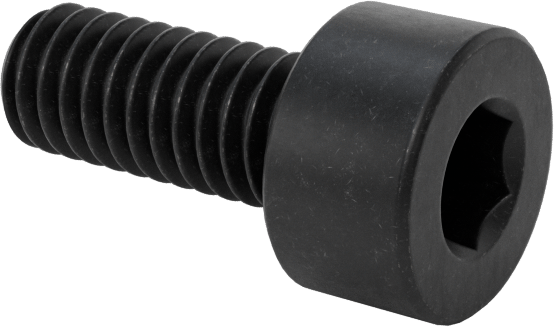
docs/assets/images/91290A101_2d622f8b-3c28-4a8b-9832-15b6ba9e981d@4x_638090344480111980-20c283fe82cabf8ed7d289f3393e69f2.png
