LightWare-Optoelectronics/lightware-dji-sdk/docs/assets/images/91290A111_f88235b2-ddc8-48db-8310-846090a0d97b@4x_638090347662764568-f8525e3b21a696a13402242b5bf79258.png

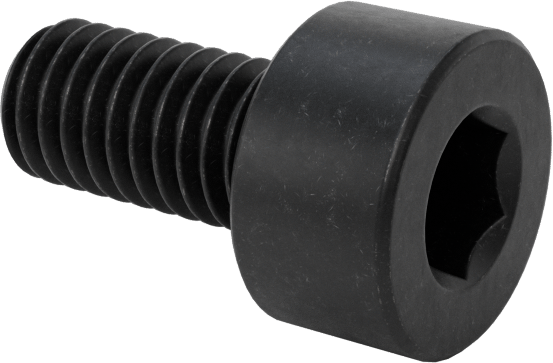
docs/assets/images/91290A111_f88235b2-ddc8-48db-8310-846090a0d97b@4x_638090347662764568-f8525e3b21a696a13402242b5bf79258.png
