LightWare-Optoelectronics/lightware-dji-sdk/docs/assets/images/91290A115_11954c9c-cc14-46f3-9b9a-e32e386d184b@4x_638090348326009646-aad3db3cb29cbba45950b80222709b73.png

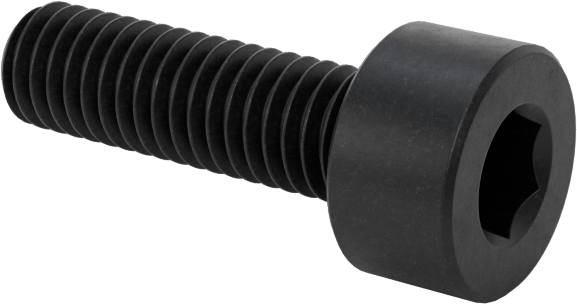
docs/assets/images/91290A115_11954c9c-cc14-46f3-9b9a-e32e386d184b@4x_638090348326009646-aad3db3cb29cbba45950b80222709b73.png
