LightWare-Optoelectronics/lightware-dji-sdk/docs/assets/images/93655A102_8b276d34-d82f-4b0f-b7db-c24ce1fd920b@4x_638061904696346096-74e8ce19fdf51c621e30c92ae49b0b52.png

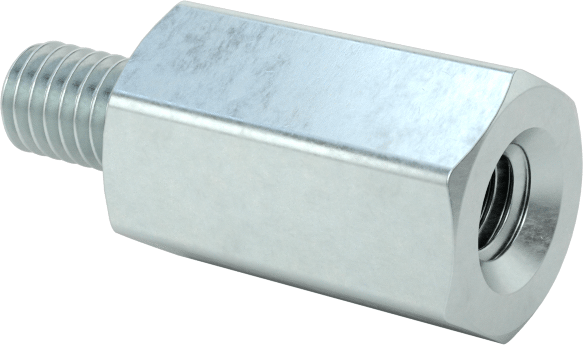
docs/assets/images/93655A102_8b276d34-d82f-4b0f-b7db-c24ce1fd920b@4x_638061904696346096-74e8ce19fdf51c621e30c92ae49b0b52.png
