LightWare-Optoelectronics/lightware-dji-sdk/docs/assets/images/94180A321_9d753935-29dc-48fe-8f60-0471be7cdec3@4x_638110316892242573-2-71a50927403438b588a07a5f7681646e.png

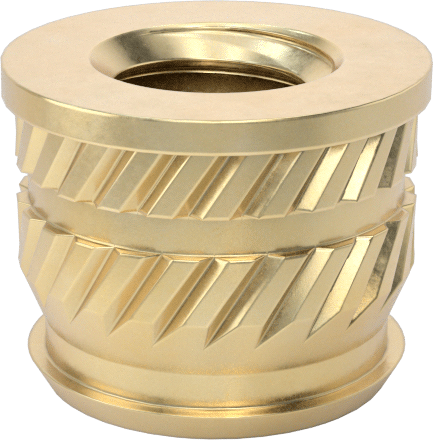
docs/assets/images/94180A321_9d753935-29dc-48fe-8f60-0471be7cdec3@4x_638110316892242573-2-71a50927403438b588a07a5f7681646e.png
