LightWare-Optoelectronics/lightware-dji-sdk/docs/assets/images/94180A331_547143ff-2c39-4e2c-b173-8ef829c5d790@4x_638110317074109560-a94d2b7c69fcf414450c276e526caa1e.png

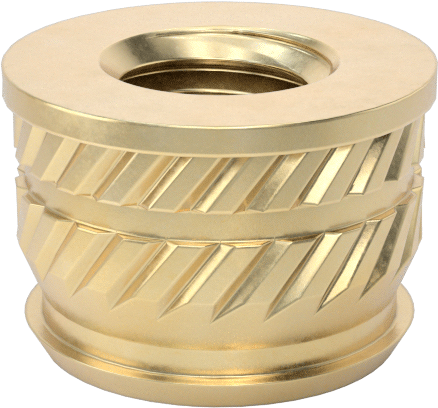
docs/assets/images/94180A331_547143ff-2c39-4e2c-b173-8ef829c5d790@4x_638110317074109560-a94d2b7c69fcf414450c276e526caa1e.png
