LightWare-Optoelectronics/lightware-dji-sdk/docs/assets/images/95893A423_9bf75529-7c07-4417-9316-ec0a718677c31700601564@4x_1700601567-dfcdf3e90b8d1da6adf7da26c644dd19.png

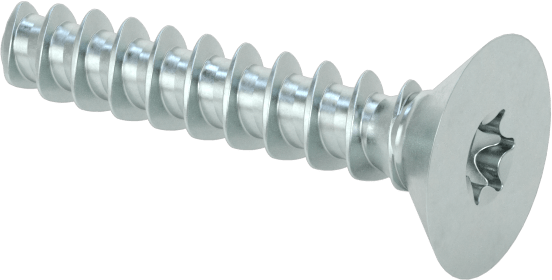
docs/assets/images/95893A423_9bf75529-7c07-4417-9316-ec0a718677c31700601564@4x_1700601567-dfcdf3e90b8d1da6adf7da26c644dd19.png
