LightWare-Optoelectronics/lightware-dji-sdk/docs/assets/images/Accessories_LW20mountingbracket_01_V001-1-f81b8cc297d1310c7ba5fef6fef2ef84.png

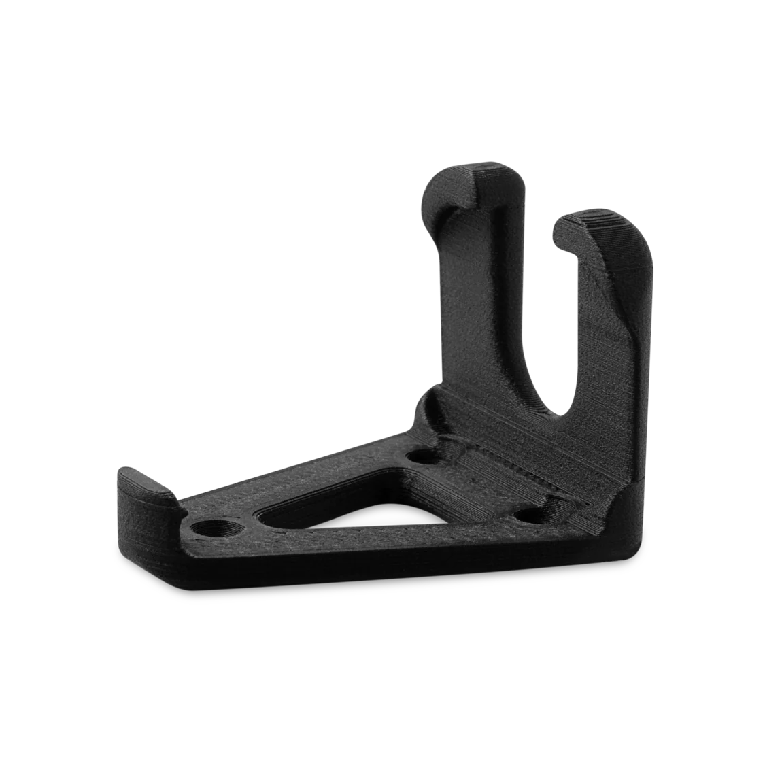
docs/assets/images/Accessories_LW20mountingbracket_01_V001-1-f81b8cc297d1310c7ba5fef6fef2ef84.png
