LightWare-Optoelectronics/lightware-dji-sdk/docs/assets/images/DJILandingSequence-265aa253fa595bb2feeaa99f435b243b.png

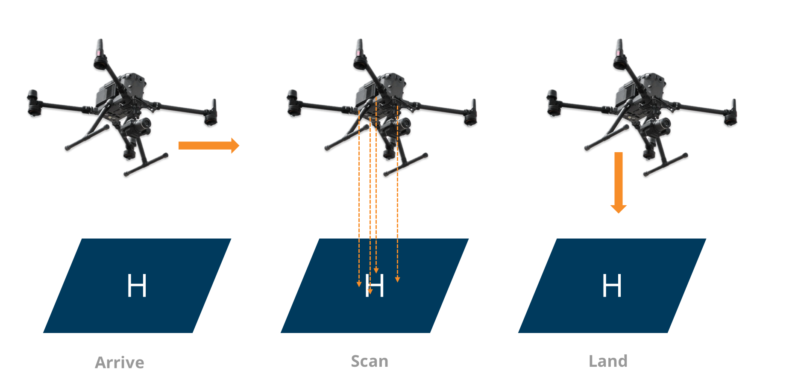
docs/assets/images/DJILandingSequence-265aa253fa595bb2feeaa99f435b243b.png
