LightWare-Optoelectronics/lightware-dji-sdk/docs/assets/images/ec8b074f205b5022081ae43a8f386753@origin-6abcbc4445c4cb3d57a1513d1d321207.jpg

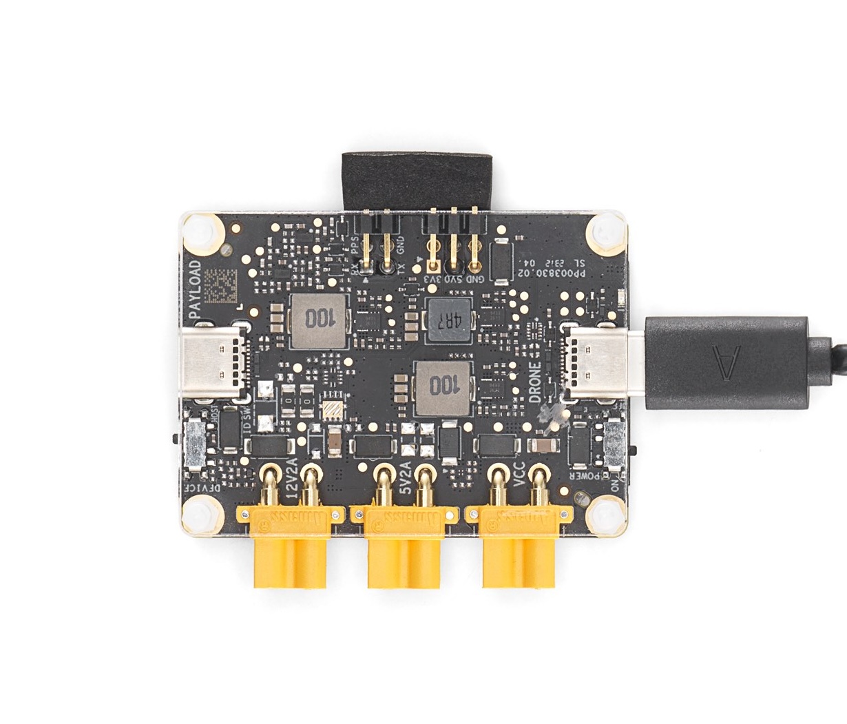
docs/assets/images/ec8b074f205b5022081ae43a8f386753@origin-6abcbc4445c4cb3d57a1513d1d321207.jpg
