LightWare-Optoelectronics/lightware-dji-sdk/docs/assets/images/EPort_RPi Mount v8-b6688369bb2b345baa063fa2de0d6948.png

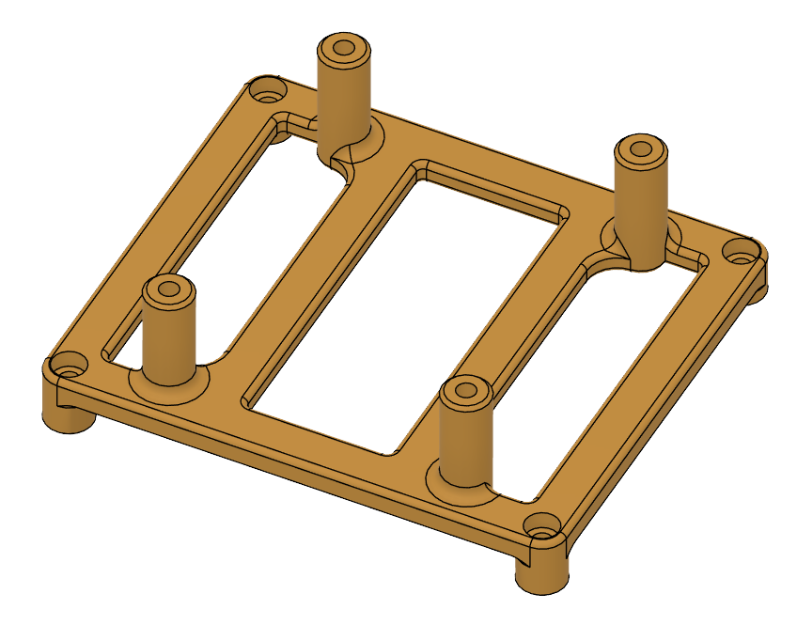
docs/assets/images/EPort_RPi Mount v8-b6688369bb2b345baa063fa2de0d6948.png
