LightWare-Optoelectronics/lightware-dji-sdk/docs/assets/images/Generic_usb-a037783e56964f6287bb930e7a9b8cbe.jpg

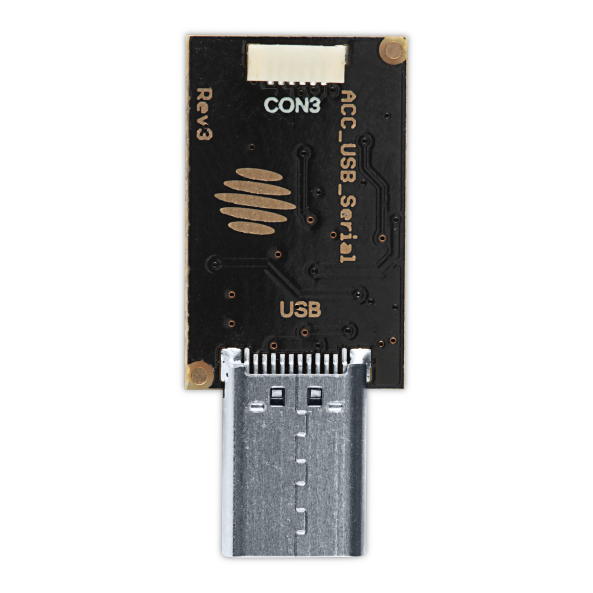
docs/assets/images/Generic_usb-a037783e56964f6287bb930e7a9b8cbe.jpg
