LightWare-Optoelectronics/lightware-dji-sdk/docs/assets/images/LW20 M350RTK Mounting Plates v12-3469e907529d9758d5e1efd49cf6826c.png

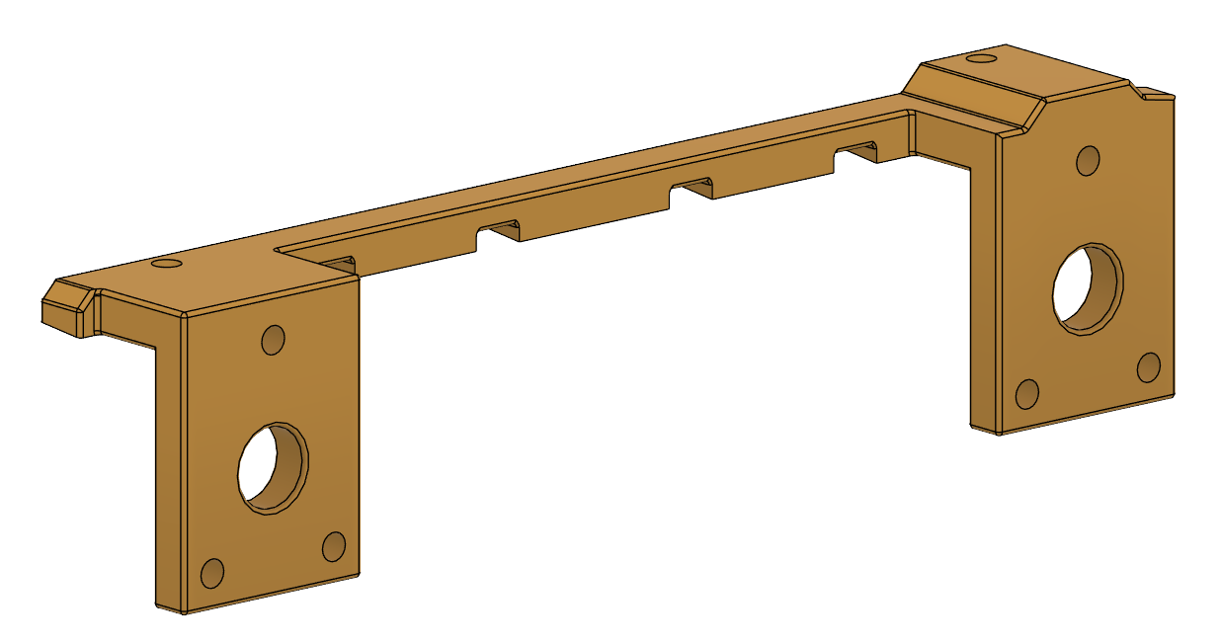
docs/assets/images/LW20 M350RTK Mounting Plates v12-3469e907529d9758d5e1efd49cf6826c.png
