LightWare-Optoelectronics/lightware-dji-sdk/docs/assets/images/LW20Hero_V001_720x-0ae610aa098eceafb9fb7fd39511304e.webp

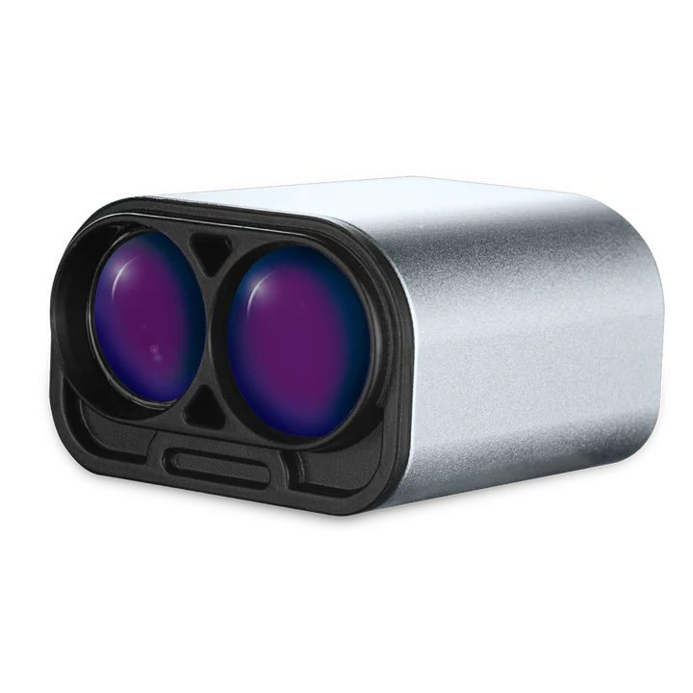
docs/assets/images/LW20Hero_V001_720x-0ae610aa098eceafb9fb7fd39511304e.webp
