LightWare-Optoelectronics/lightware-dji-sdk/docs/assets/images/M350-RTK-Front-d0268d1c8d026230d899161a144c9597.png

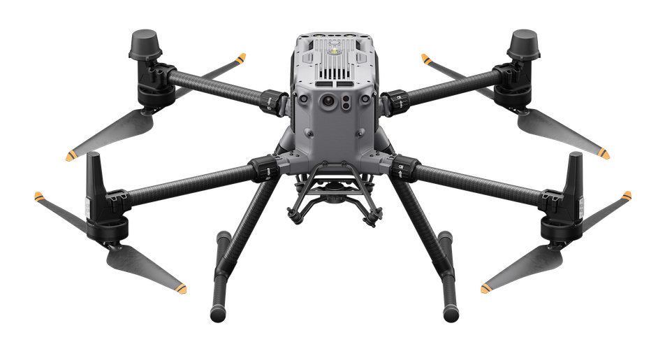
docs/assets/images/M350-RTK-Front-d0268d1c8d026230d899161a144c9597.png
