LightWare-Optoelectronics/lightware-dji-sdk/docs/assets/images/Voltage Reg Mount v8-a4e6ff3bbea44571a2d9cf7f60e9e2ec.png

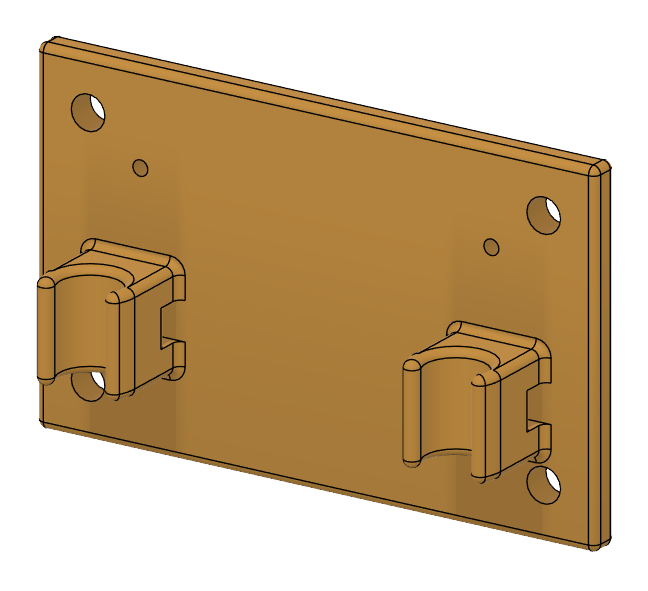
docs/assets/images/Voltage Reg Mount v8-a4e6ff3bbea44571a2d9cf7f60e9e2ec.png
