LightWare-Optoelectronics/lightware-dji-sdk/cad/Forward Laser Mount v3.step

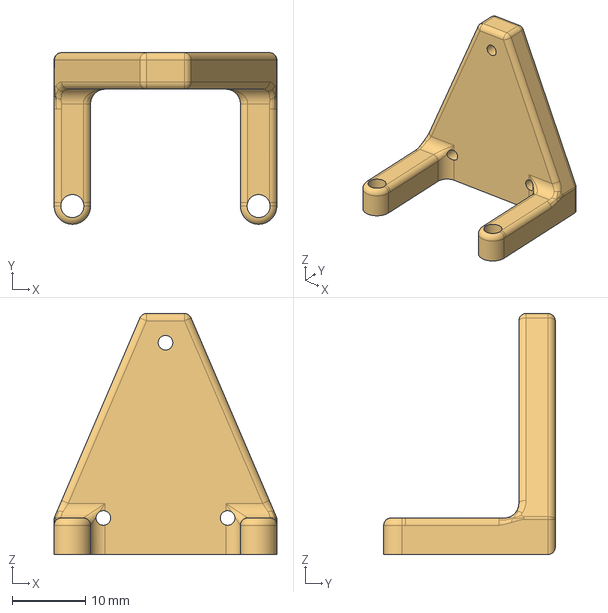
[picture p53: CAD file, 2024-11-29]
cad/Forward Laser Mount v3.step
30.5 x 23.5 x 33.0 mm
