LightWare-Optoelectronics/lightware-dji-sdk/docs/assets/files/Voltage Reg Mount v17-343714891c7bbfe09b82b1dcf9bec890.step

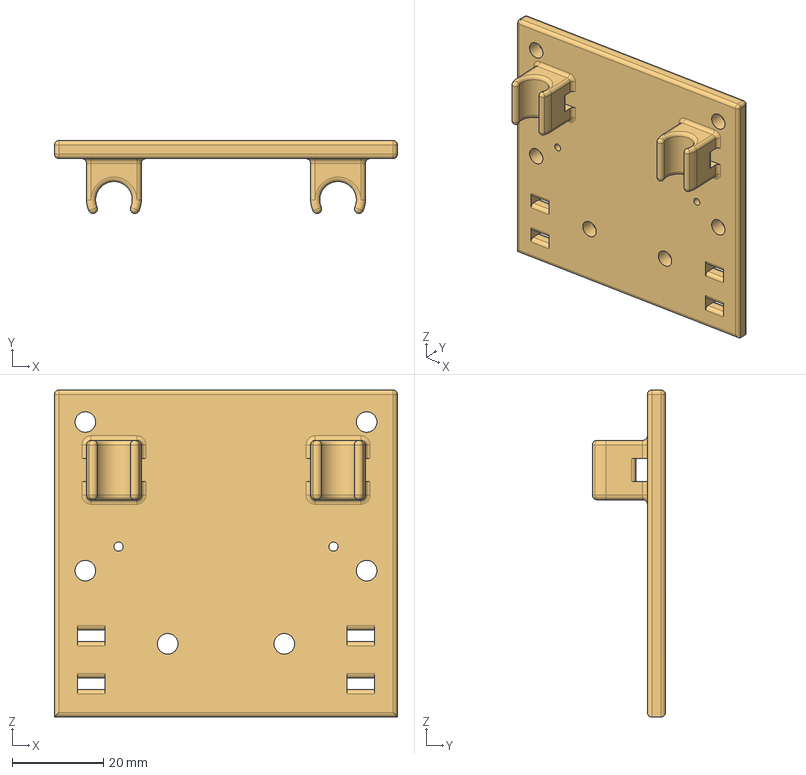
[picture p54: CAD file, 2024-11-29]
docs/assets/files/Voltage Reg Mount v17-343714891c7bbfe09b82b1dcf9bec890.step
75.0 x 16.0 x 71.5 mm
