LightWare-Optoelectronics/lightware-dji-sdk/cad/EPort-RPi Mount v13.step

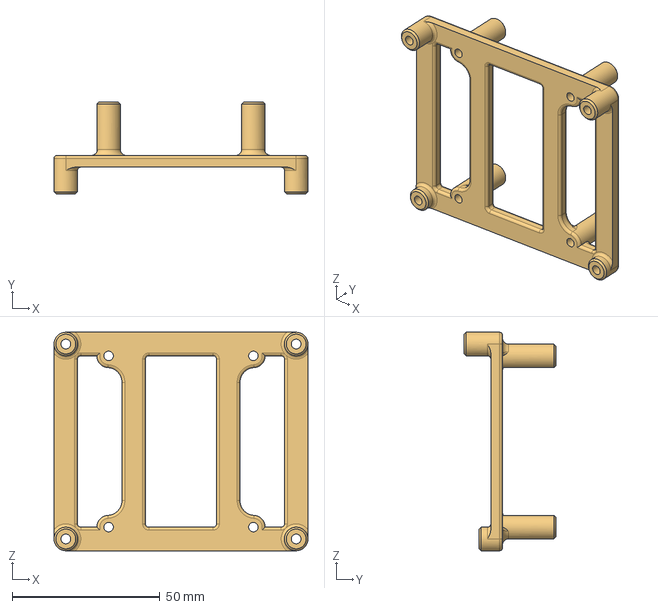
[picture p55: CAD file, 2024-11-29]
cad/EPort-RPi Mount v13.step
86.0 x 31.0 x 74.0 mm
