LightWare-Optoelectronics/lightware-dji-sdk/docs/assets/files/LW20 M350RTK Mounting Plates v14-49eb36f82dcae04970cc9d7012e1ab2e.step

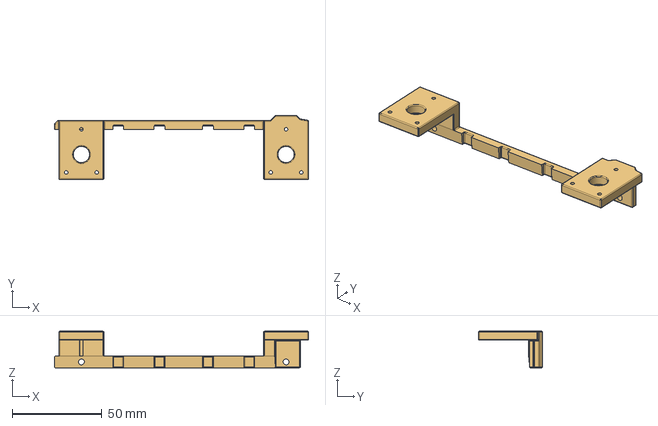
[picture p56: CAD file, 2024-11-29]
docs/assets/files/LW20 M350RTK Mounting Plates v14-49eb36f82dcae04970cc9d7012e1ab2e.step
141.5 x 35.8 x 20.4 mm
