LightWare-Optoelectronics/lightware-dji-sdk/cad/Forward Laser Mount - SF30D v2.step

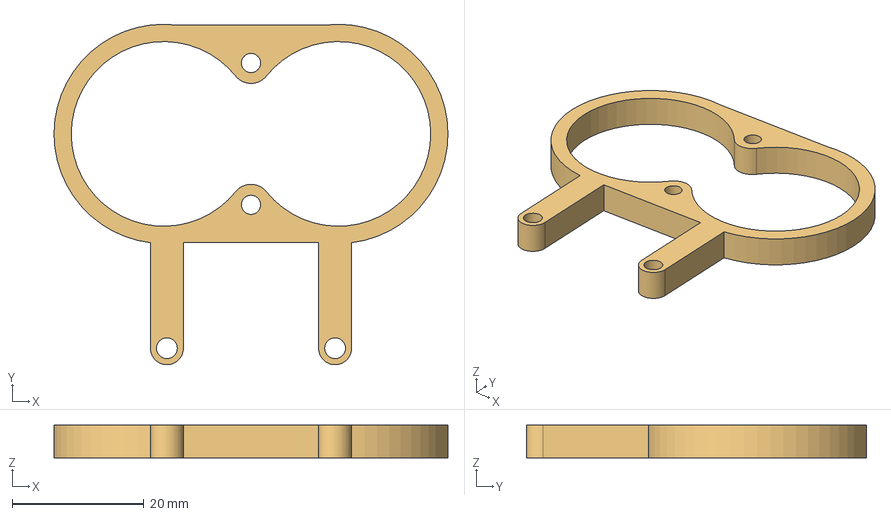
[picture p57: CAD file, 2024-11-29]
cad/Forward Laser Mount - SF30D v2.step
59.7 x 51.6 x 5.00 mm
