LightWare-Optoelectronics/lightware-dji-sdk/(list of files, cad)

Other CAD files:
docs/assets/files/EPort-RPi Mount v13-dbb6c2c425ba9a82a9840f34459f9581.stl
docs/assets/files/LW20 M350RTK Mounting Plates v14-9398eccd02475ddd3e8ace2bc4d14dbf.stl
docs/assets/files/Voltage Reg Mount v17-2018e6229aae016554bd6398e951a0b9.stl
cad/EPort-RPi Mount v13.stl
cad/Forward Laser Mount - SF30D v2.stl
cad/Forward Laser Mount v3.stl
cad/LW20 M350RTK Mounting Plates v14.stl
cad/Voltage Reg Mount v17.stl
